kaansancakdar/Stewart_Platform/Lecture__Mathematics of the Stewart Platform.pdf

## The Mathematics of the Stewart Platform

The Stewart Platform consists of 2 rigid frames connected by 6 variable length legs.

The Base is considered to be the reference frame work, with orthogonal axes x, y, z.

The Platform has its own orthogonal coordinates x’, y’, z’.

The Platform has 6 degrees of freedom with respect to the Base

The origin of the Platform coordinates can be defined by 3 translational displacements with respect to the Base, one for each axis.

Three angular displacements then define the orientation of the platform with respect to the Base. A set of Euler angles are used in the following sequence:

1. Rotate an angle ψ (yaw) around the z-axis
2. Rotate an angle θ (pitch) around the y-axis
3. Rotate an angle (roll) around the x-axis

If we consider the first rotation ψ (yaw) around the z-axis:

P = i’x’ + j’y’ + k’z’ = ix + jy + kz

x = OA – BC

= x’cos ψ – y’sin ψ

y = AB + PC

= x’sin ψ + y’cos ψ

z = z’


We define the rotation matrix | where

=

and | =

Similarly If we consider the second rotation θ (pitch) around the y-axis we can show

=

,

And for the third rotation (roll) around the x-axis:

=

The full rotation matrix of the Platform relative to the Base is then given by:

=

=

=

=

- (1)

Now consider a Stewart Platform.

For the

leg:

Platform; Base

The coordinates | of the anchor point | with respect to the Base reference framework are
given by the equation

= T +

- (2)

Where T is the translation vector, giving the positional linear displacement of the origin of the Platform frame with respect to the Base reference framework, and

is the vector defining the coordinates of the anchor point with respect to the Platform framework.

Similarly the length of the

leg is given by

| = T +

- (3)
| where is the vector
defining the coordinates of the lower anchor point
| . These 6 equations give the lengths
of the 6 legs to achieve the desired position and attitude of the platform.

When considering the Forward Kinematics, this expression represents 18 simultaneous non-linear equations in the 6 unknowns representing the position and attitude of the platform. Much work has been done on finding the solutions to these equations; in the general case there are 40 possible solutions, although in practice many of these solutions would not be practical.

If the leg lengths are achieved via rotational servos, rather than linear servos, a further calculation is required to determine the angle of rotation of the servo. Each servo / leg combination can be represented as follows:

Axis of servo motor in x-y plane

y

z

Where: a = length of the servo operating arm

are the points of the arm/leg joint on the

servo with coordinates

=

in the base framework.

are the points of rotation of the servo arms with the coordinates

=

in the base framework.

are the points the joints between the operating rods and the platform,

with coordinates | =

in the platform framework

S = length of operating leg

= length of the
leg as calculated from

= T +

α = angle of servo operating arm from horizontal

β = angle of servo arm plane relative to the x-axis. Note that the shaft axis lies in the x-y plane where z = 0

z-axis; y-axis; x-axis; Sweep of arm; (i=even); (i=odd)

Point is constrained to be on the servo arm, but the arrangement of the servos means that the odd and even arms are a reflection of each other. So for the even legs we have:

= a | , and | - (4)
= a | , and | - (5)

= a | - (6)

And for the odd legs we have:

= a | , and
= a | , and

= a

But | = | , and | =
And | = | , and | =

Substituting these values into the equations for the odd legs, we get the same equations as (4), (5), and (6) for the even legs.

By Pythagoras we also have:

=

+

+

=

+

- 2
- (7)

=

+

+

=

+

- 2 | - (8)

=

+

+

=

+

- 2

And substituting from equations (7) & (8)

=

+ 2 | +

+
2
- 2

re-arranging gives

= 2

+ 2 | + 2 | + 2 | –
2
And substituting for | , | , | from equations (4), (5) & (6) then gives

= 2

+ 2

+
2

+ 2

2

= 2

+ 2 | + 2 | - 2

+
2a | + 2 | - 2
+ 2a | + 2 | -
2

Which reduces to

= 2a | 2 | + 2a
= 2a | 2a

Which is an equation of the form:-

L =

Using the Trig identity for the sum of sine waves

where

and

We therefore have another sine function of α with a phase shift δ

L = | where | δ =
Therefore | =
And | α =

- (9)

where L =

M = 2a

N = 2a

We now have sufficient information to calculate the lengths of the effective “legs”, and the associated angle of the servo arms, for the reverse kinematics for the platform. But to design and implement the hexapod platform we need to define a few constants in order to define the range of movement.

1) We need to define the “home” position of the platform. By definition this will be where the platform is at a height above the base framework, and there being no other translational or rotational movement.

i.e.

= T +

=

=

Similarly we will define the “home” position where the servo arms and rods are at right angles to each other.

i.e.

=

Giving

- (10)

and since the platform is constructed symmetrically around the z-axis, this equation will give the same result for any leg.

2) We can also calculate the angle of the servo arm at the Home position.

Using the equation

= T +

And remembering the symmetrical construction of the platform. The length of the legs in the “home” position is given by

- (11)

And the angle of the servo arm in the “home” position can be given by equation (9). Since we have symmetry, we can look at leg 2 only, where β = 0°.

=

- (12)

where =

= 2

| = 2a
| = 2a
| = 2a

The servos are mounted so that their mid point is close to the “home” position, and we will restrict their movement to ± 45°. The servos are controlled by a pulse whose duration defines the angle of the arm.

Pulse; Repetition every 20 msecs

The servos used have the specification:

Neutral position (“home”) is nominally 1500µsecs

Rotation clockwise for increasing pulse width

Pulse width change for 45° is 400 µsecs giving a servo rate,

r =

=

µsecs / radian

From the above, the pulse widths

for each of the servos can be obtained by the equations:

for even i and | -(13)
for odd i | - (14)

Where

is the actual pulse width required to hold the | servo in the “home”
position. This is nominally 1500µsecs, but can be adjusted to compensate for differences in actual assembly.

## Controlling the Stewart Platform using RC Servos

The platform is constructed with symmetry round the z-axes, but the odd and even servos are mounted in opposition.

The circuitry used to control the platform is based on a PICAXE microcontroller with attached maths co-processor (floating point) and attached servo motor controller.

PICAXE 40X2; µM-FPU; µM-PWM; I2c interface; Input position variables; Pulse output to servos

The sequence of events is as follows:

1) Input the positional information for the platform,

s, a,

. These are all
constants from the build of the platform.
2) Input the constants for the servo motors,

and r
3) Calculate the values of | from equation (10), and | from equation (12)
4) Input the variables for (x, y, z, ψ, θ, φ) for the required platform position
5) Calculate the rotational matrix

from equation (1)
6) Calculate the effective leg lengths
from equations (3)
7) Calculate the angles

required for each servo from equation (9)
8) Calculate the pulse widths

required for each servo from equations (13) & (14)
9) Output the values of

to the µM-PWM to drive the servos
10) Return to step 4) to repeat the process.
