kaansancakdar/Stewart_Platform/memememe-master/memememe-master/Processing/StewartSimulator/README.md

###Stewart Platform Simulator

Math based on [this document](http://www.wokinghamu3a.org.uk/Maths%20of%20the%20Stewart%20Platform%20v5.pdf) by an unknown author from the [U3A Maths Group](http://www.wokinghamu3a.org.uk/Maths.html)  

###Dependencie:  
- [peasycam](http://mrfeinberg.com/peasycam/)  
- [controlP5](http://www.sojamo.de/libraries/controlP5/)  
- [oscP5](http://www.sojamo.de/libraries/oscP5/)
