kaansancakdar/Stewart_Platform/CAD/New Microsoft PowerPoint Presentation.pptx

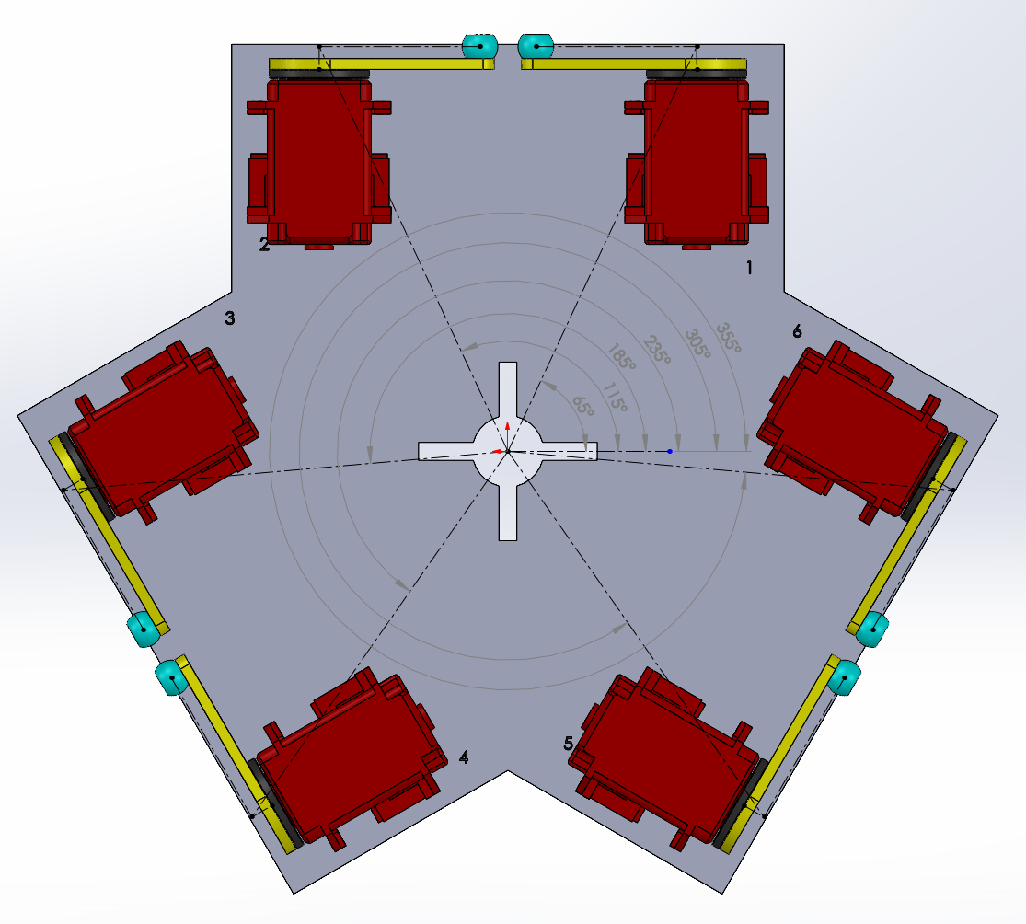
[picture p15: figure]

## Slide 2

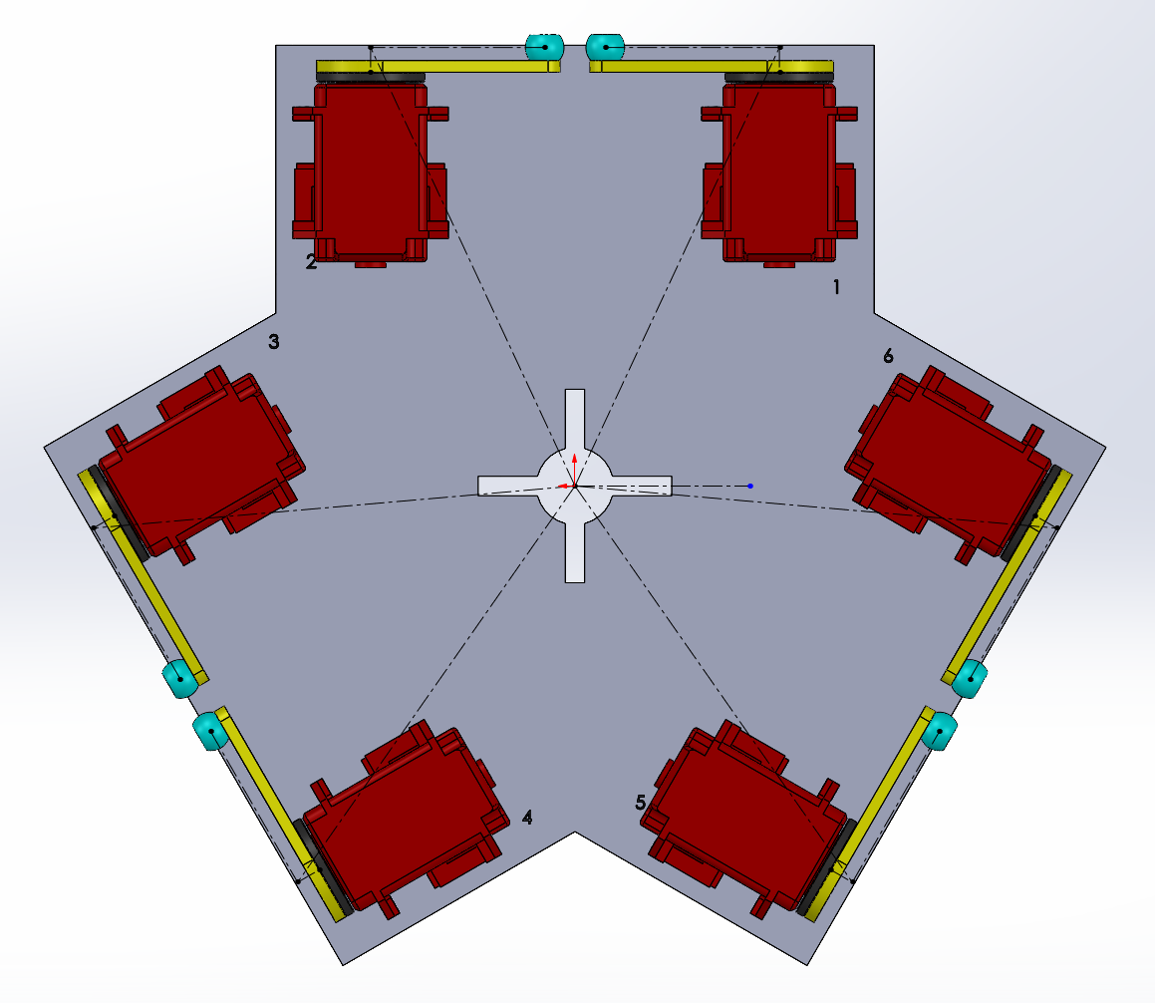
[picture p16: figure]

## Slide 3

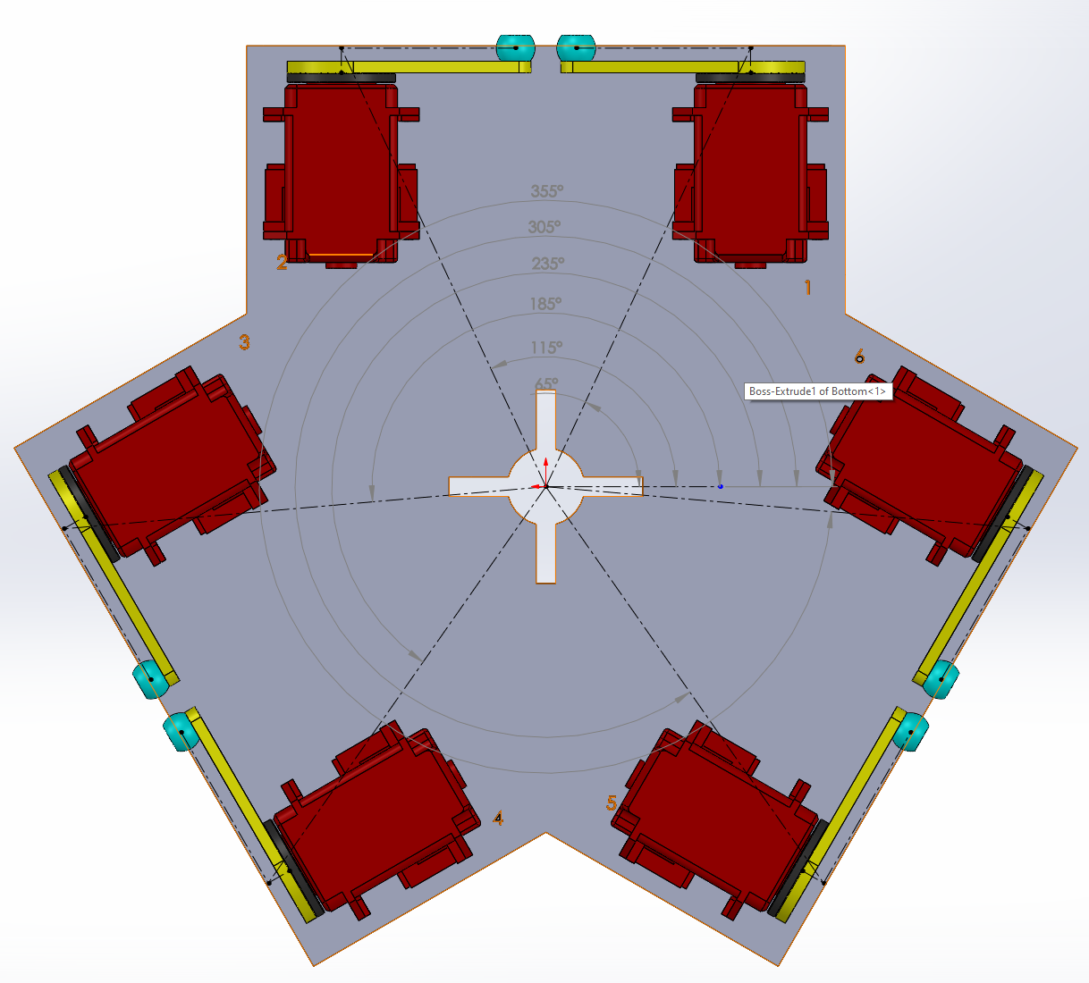
[picture p17: figure]
