kaansancakdar/Stewart_Platform/Literature/F2ES5AQHW0FU98M.png

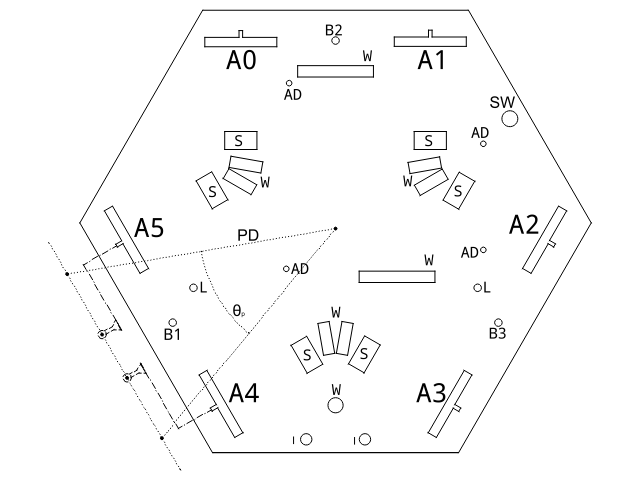
Literature/F2ES5AQHW0FU98M.png
