kaansancakdar/Stewart_Platform/Literature/F15E12CHW1M979X.png

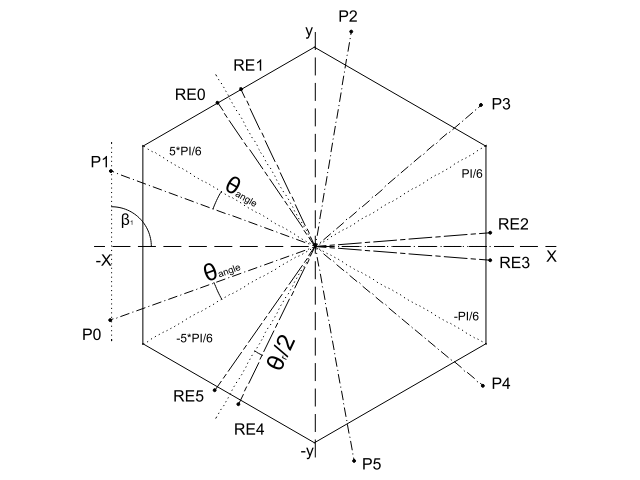
Literature/F15E12CHW1M979X.png
