kaansancakdar/Stewart_Platform/CAD/Assem1.SLDASM

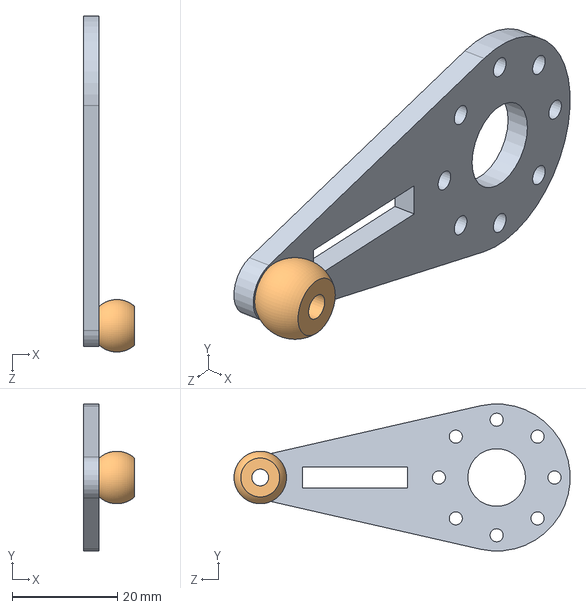
[picture p27: CAD file, 2025-04-02]
CAD/Assem1.SLDASM
9.73 x 27.9 x 64.0 mm
ServoArm
BallJoint2
