kaansancakdar/Stewart_Platform/CAD/LinearActuated.SLDASM

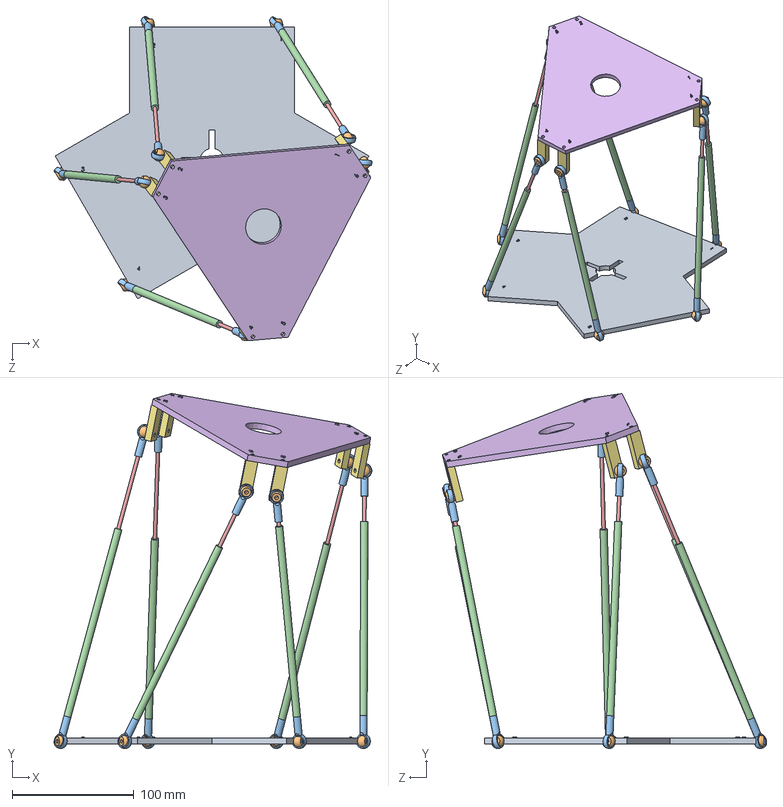
[picture p28: CAD file, 2025-04-02]
CAD/LinearActuated.SLDASM
261.5 x 292.1 x 267.0 mm
Bottom_1
BallJoint2 x 12
BallJoint_1 x 12
Link_2 x 6
Link_1 x 6
Platform_1
JointHolder x 6
