kaansancakdar/Stewart_Platform/CAD/Stewart_Platform_CAD/STW_001000.SLDASM

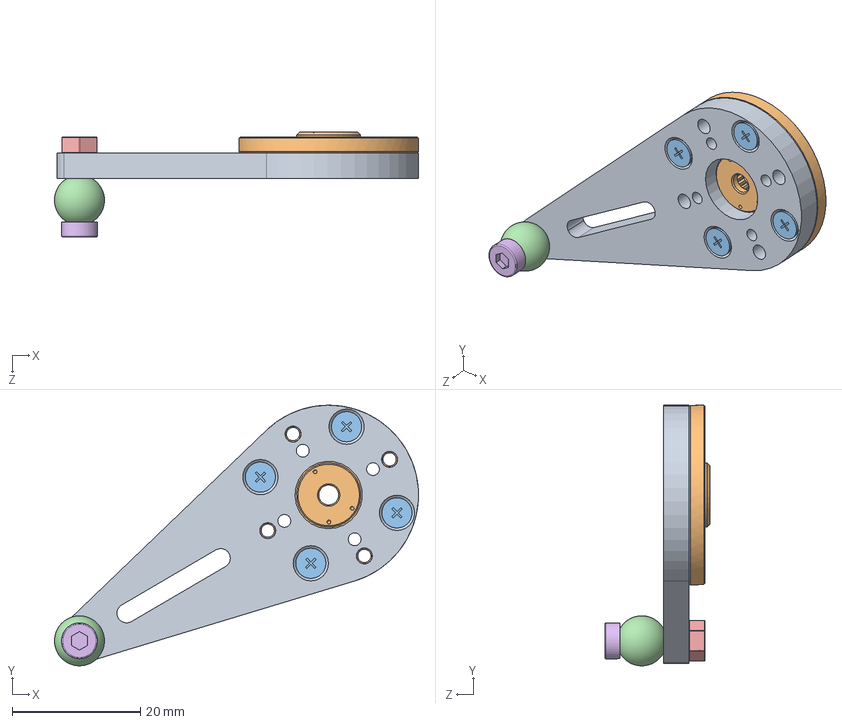
[picture p29: CAD file, 2025-04-02]
CAD/Stewart_Platform_CAD/STW_001000.SLDASM
56.7 x 40.6 x 16.4 mm
STW_0010001
Dynamixel_HN05-N102
DIN965-M2.5x6 x 4
BallJoint_Ball
C.020.00000753-(#DIN934-M3_Nut)
C.020.00000880-(#DIN912-M3x12_Socket Head Screw)
