kaansancakdar/Stewart_Platform/CAD/Assem0.SLDASM

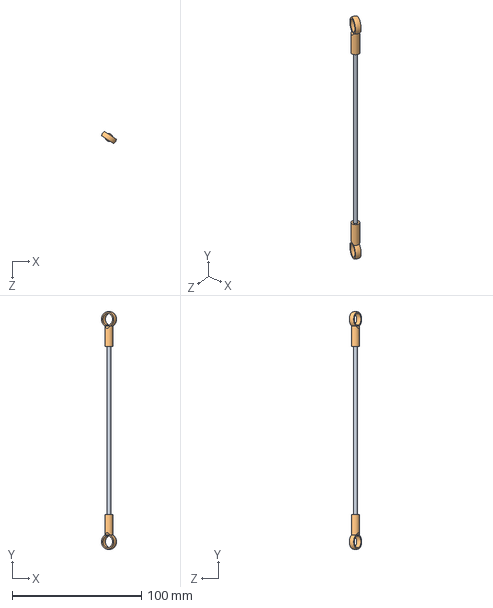
[picture p30: CAD file, 2025-04-02]
CAD/Assem0.SLDASM
11.7 x 184.0 x 9.55 mm
Link_1
BallJoint_1 x 2
