kaansancakdar/Stewart_Platform/CAD/Stewart_Platform_CAD/STW_005000.SLDASM

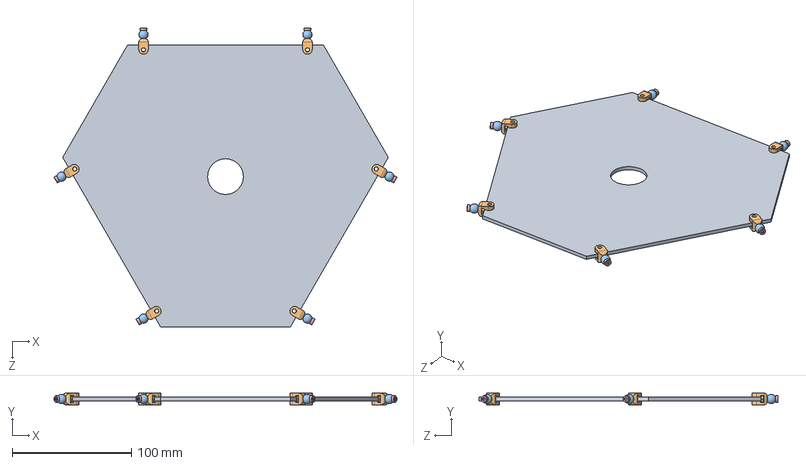
[picture p31: CAD file, 2025-04-02]
CAD/Stewart_Platform_CAD/STW_005000.SLDASM
287.1 x 10.0 x 250.7 mm
STW_003001
STW_004001 x 6
BallJoint_Ball x 6
C.020.00000753-(#DIN934-M3_Nut) x 6
C.020.00000880-(#DIN912-M3x12_Socket Head Screw) x 6
