kaansancakdar/Stewart_Platform/CAD/Stewart_Platform_CAD/STW_002000.SLDASM

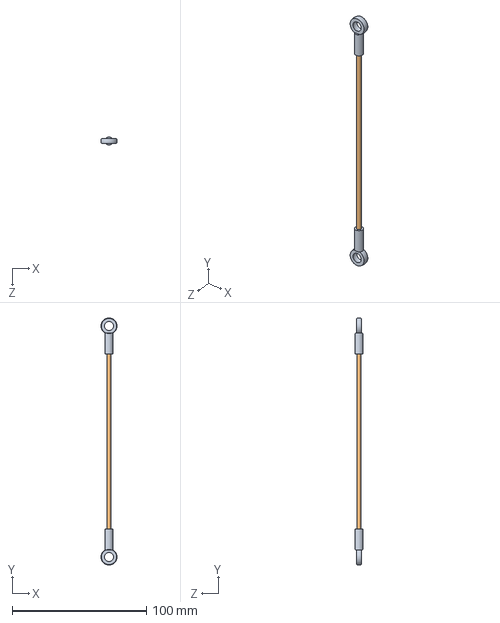
[picture p32: CAD file, 2025-04-02]
CAD/Stewart_Platform_CAD/STW_002000.SLDASM
12.0 x 184.0 x 5.98 mm
BallJoint_Pin x 2
STW_0020001
