kaansancakdar/Stewart_Platform/CAD/Assem2.SLDASM

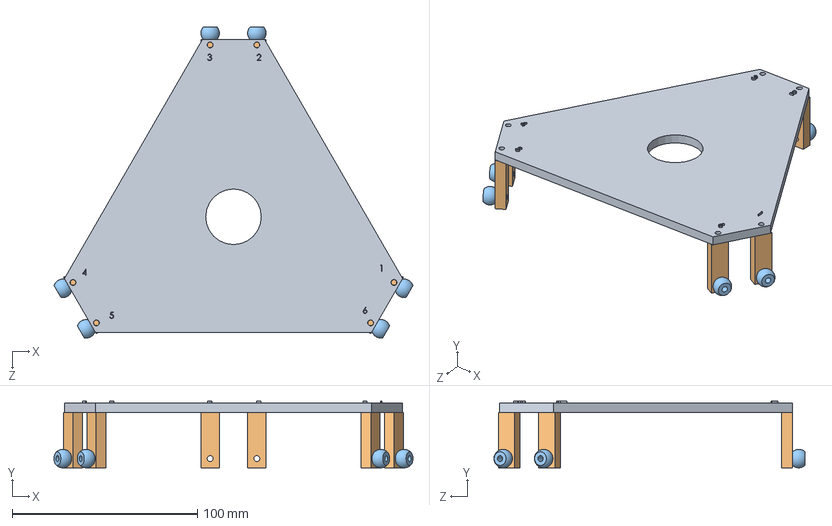
[picture p33: CAD file, 2025-04-02]
CAD/Assem2.SLDASM
193.9 x 36.0 x 168.0 mm
Platform_1
JointHolder x 6
BallJoint2 x 6
