kaansancakdar/Stewart_Platform/CAD/Assem02.SLDASM

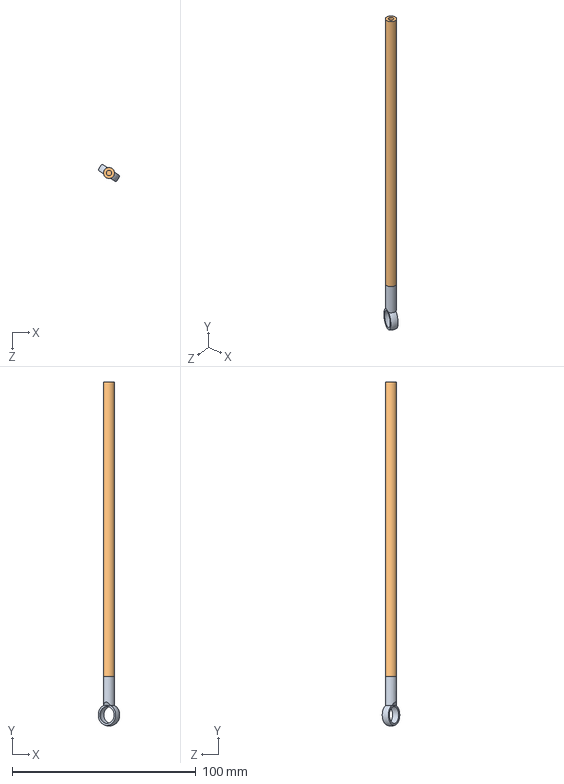
[picture p34: CAD file, 2025-04-02]
CAD/Assem02.SLDASM
11.7 x 187.0 x 9.55 mm
BallJoint_1
Link_2
