kaansancakdar/Stewart_Platform/CAD/Stewart_Platform_CAD/STW_000000.SLDASM

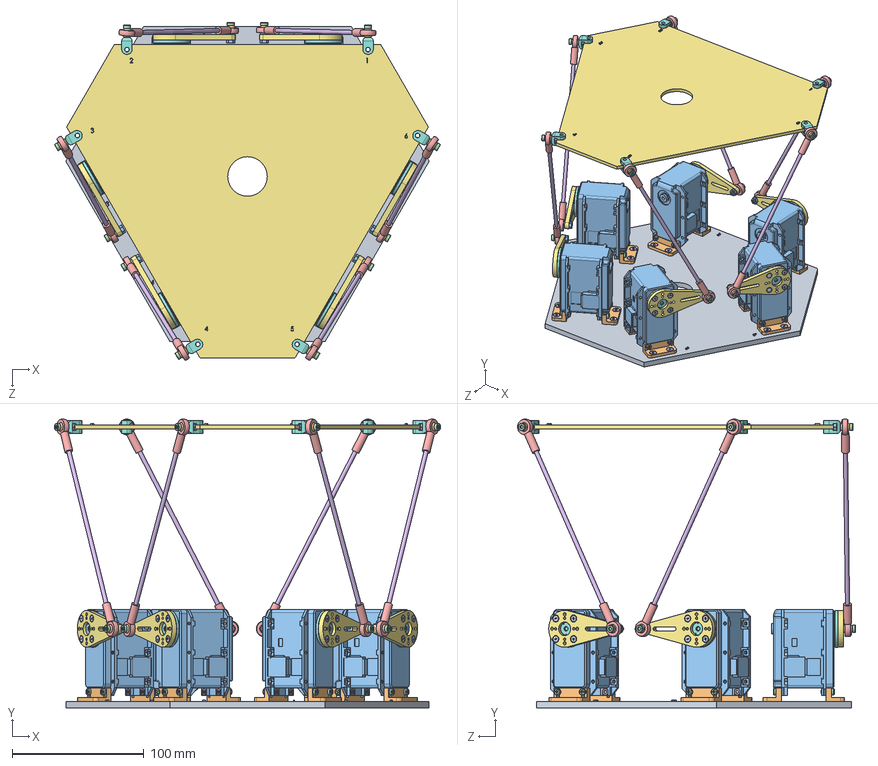
[picture p35: CAD file, 2025-04-02]
CAD/Stewart_Platform_CAD/STW_000000.SLDASM
292.6 x 219.0 x 256.1 mm
STW_000001
STW_000002 x 12
Dynamixel_MX106R x 6
C.020.00000XXX-(#DIN7985-M2.5X08MM-Machine Screw) x 24
C.020.00000XXX-(#DIN934-M2.5 NUT) x 12
C.020.00000XXX-(#DIN7991-M3X08MM HAVSA IMBUS) x 24
STW_0010001 x 6
Dynamixel_HN05-N102 x 6
DIN965-M2.5x6 x 24
BallJoint_Ball x 12
C.020.00000753-(#DIN934-M3_Nut) x 12
C.020.00000880-(#DIN912-M3x12_Socket Head Screw) x 12
BallJoint_Pin x 12
STW_0020001 x 6
STW_003001
STW_004001 x 6
