kaansancakdar/Stewart_Platform/CAD/Stewart_Platform_CAD/STW_004000.SLDASM

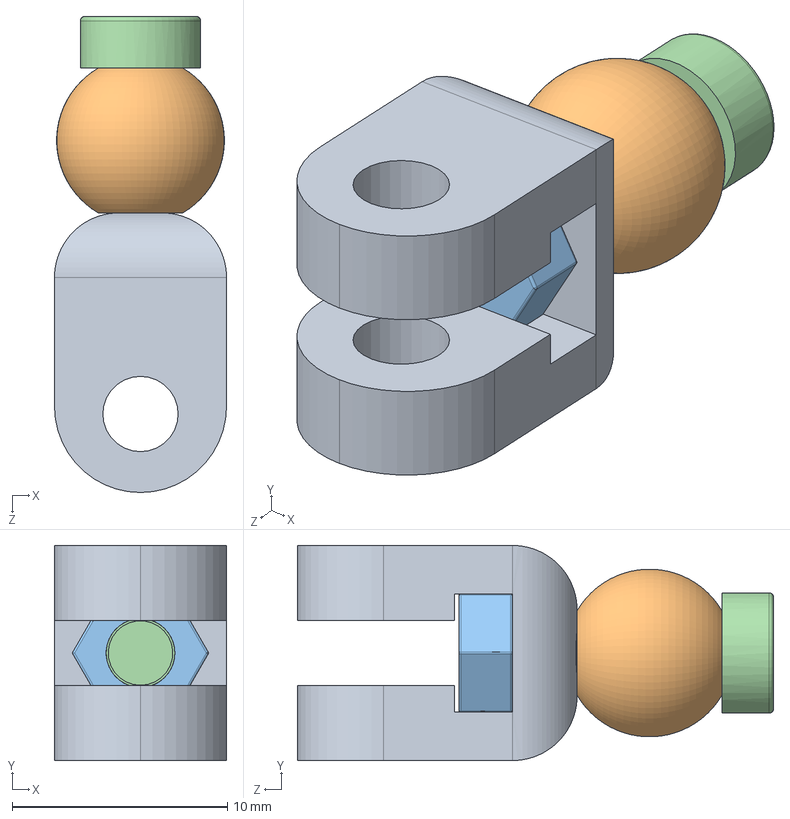
[picture p36: CAD file, 2025-04-02]
CAD/Stewart_Platform_CAD/STW_004000.SLDASM
8.00 x 10.0 x 22.1 mm
STW_004001
BallJoint_Ball
C.020.00000753-(#DIN934-M3_Nut)
C.020.00000880-(#DIN912-M3x12_Socket Head Screw)
