kaansancakdar/Stewart_Platform/CAD/Link_2.SLDPRT

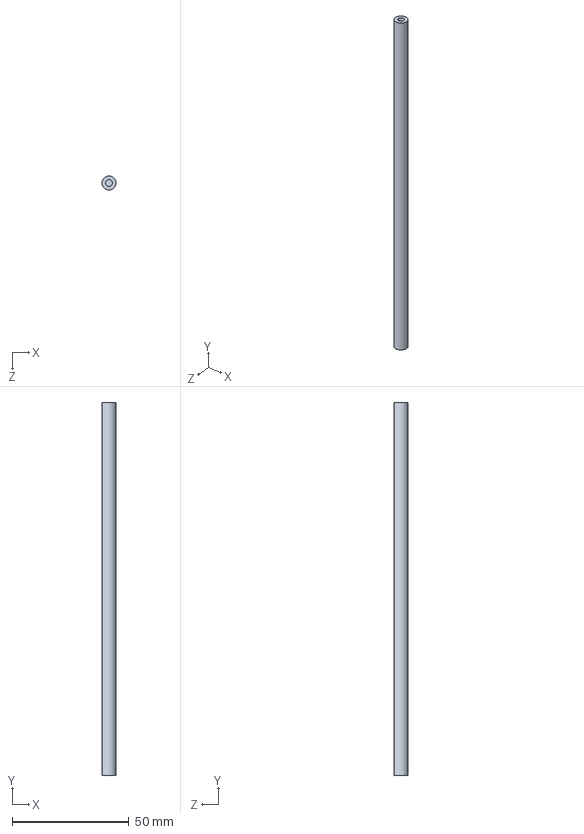
[picture p37: CAD file, 2025-04-02]
CAD/Link_2.SLDPRT
6.00 x 160.0 x 6.00 mm
