kaansancakdar/Stewart_Platform/CAD/Stewart_Platform_CAD/STW_0020001.SLDPRT

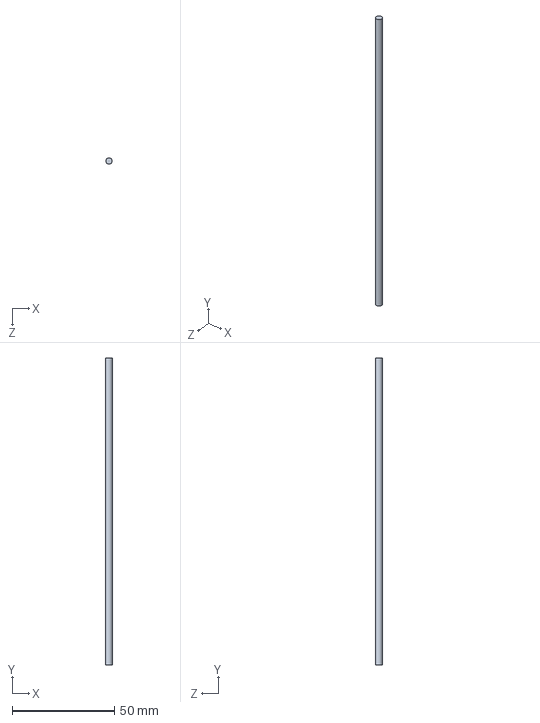
[picture p38: CAD file, 2025-04-02]
CAD/Stewart_Platform_CAD/STW_0020001.SLDPRT
3.20 x 150.0 x 3.20 mm
