kaansancakdar/Stewart_Platform/RotaryStewartPlatform-master/RotaryStewartPlatform-master/templates_for_cutting/base_bot.dxf

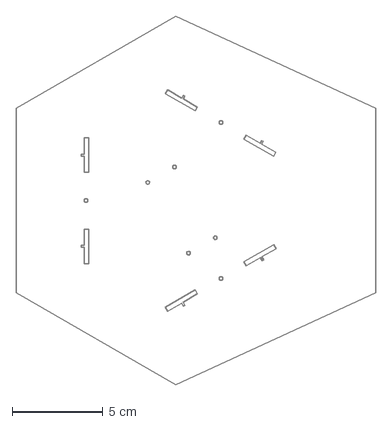
[picture p39: CAD file, 2025-04-02]
RotaryStewartPlatform-master/RotaryStewartPlatform-master/templates_for_cutting/base_bot.dxf
19.8 x 20.3 cm
