kaansancakdar/Stewart_Platform/RotaryStewartPlatform-master/templates_for_cutting/platform_bot.dxf

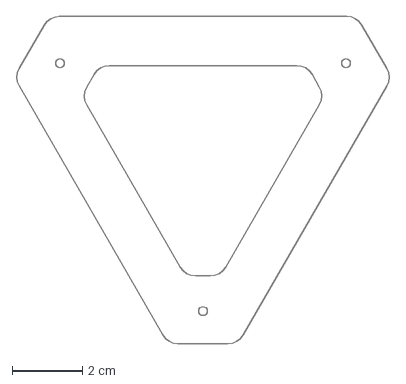
[picture p40: CAD file, 2025-04-02]
RotaryStewartPlatform-master/templates_for_cutting/platform_bot.dxf
10.6 x 9.31 cm
