kaansancakdar/Stewart_Platform/CAD/Link_1.SLDPRT

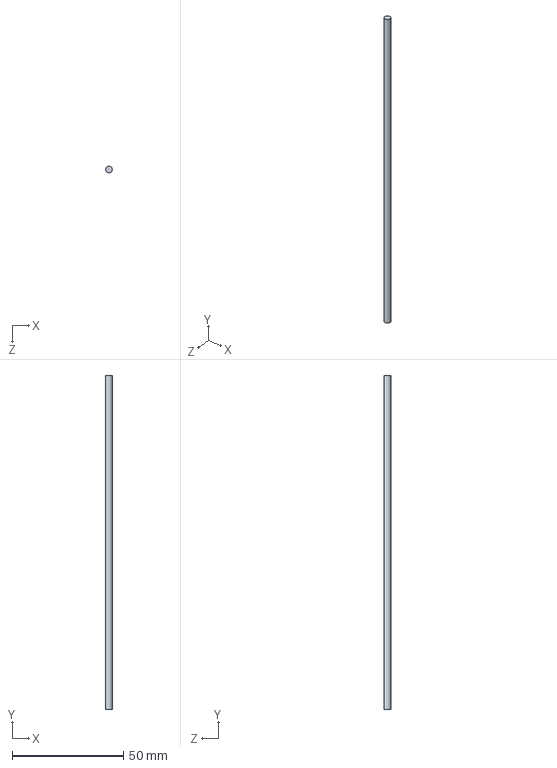
[picture p41: CAD file, 2025-04-02]
CAD/Link_1.SLDPRT
3.00 x 150.0 x 3.00 mm
