kaansancakdar/Stewart_Platform/RotaryStewartPlatform-master/RotaryStewartPlatform-master/templates_for_cutting/platform_top.dxf

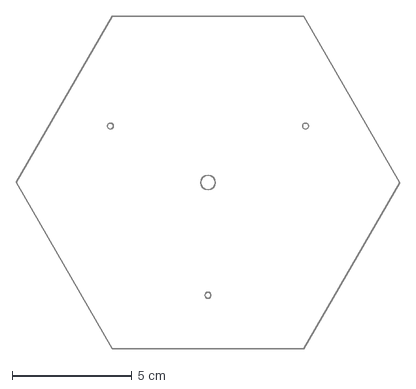
[picture p42: CAD file, 2025-04-02]
RotaryStewartPlatform-master/RotaryStewartPlatform-master/templates_for_cutting/platform_top.dxf
16.0 x 13.9 cm
