kaansancakdar/Stewart_Platform/RotaryStewartPlatform-master/templates_for_cutting/base_top.dxf

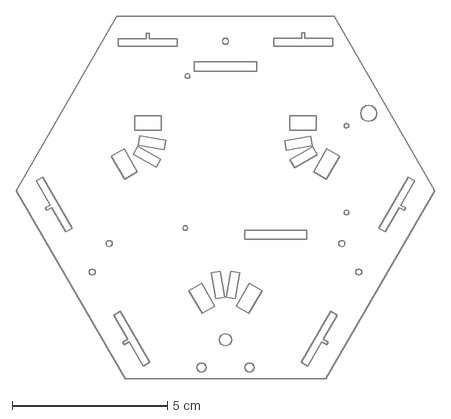
[picture p43: CAD file, 2025-04-02]
RotaryStewartPlatform-master/templates_for_cutting/base_top.dxf
13.5 x 11.7 cm
