kaansancakdar/Stewart_Platform/CAD/Stewart_Platform_CAD/STW_000003.SLDPRT

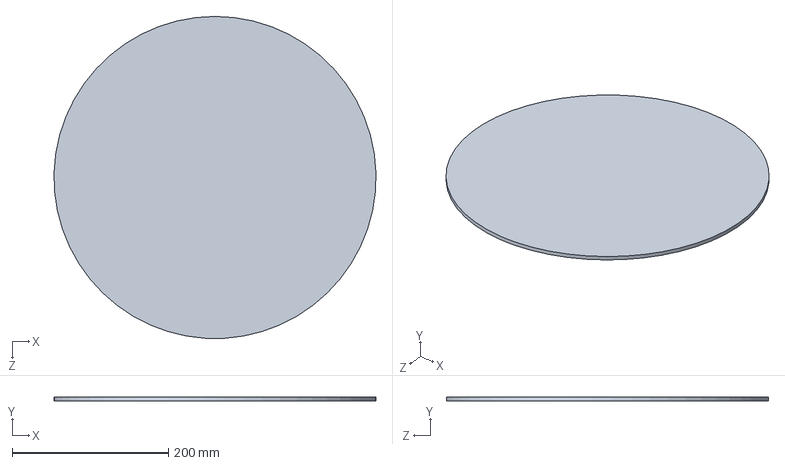
[picture p44: CAD file, 2025-04-02]
CAD/Stewart_Platform_CAD/STW_000003.SLDPRT
412.5 x 5.00 x 412.6 mm
