kaansancakdar/Stewart_Platform/RotaryStewartPlatform-master/RotaryStewartPlatform-master/templates_for_cutting/servo_arm.dxf

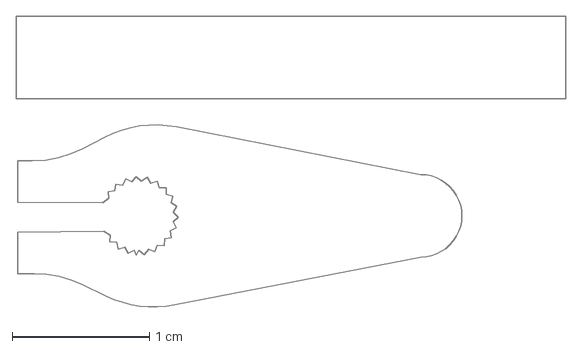
[picture p45: CAD file, 2025-04-02]
RotaryStewartPlatform-master/RotaryStewartPlatform-master/templates_for_cutting/servo_arm.dxf
4.00 x 2.13 cm
