kaansancakdar/Stewart_Platform/CAD/Bottom.SLDPRT

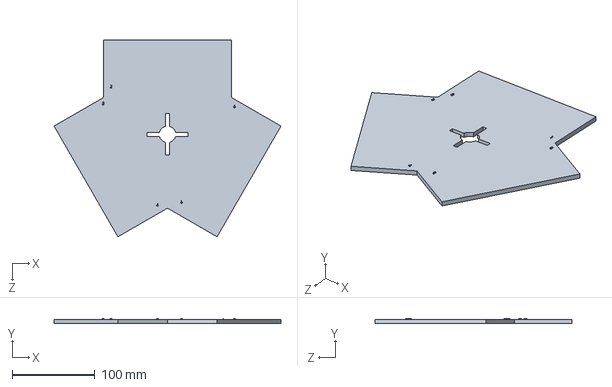
[picture p46: CAD file, 2025-04-02]
CAD/Bottom.SLDPRT
274.6 x 6.00 x 237.8 mm
