kaansancakdar/Stewart_Platform/CAD/Stewart_Platform_CAD/C.020.00000XXX-(#DIN7991-M3X08MM HAVSA IMBUS).SLDPRT

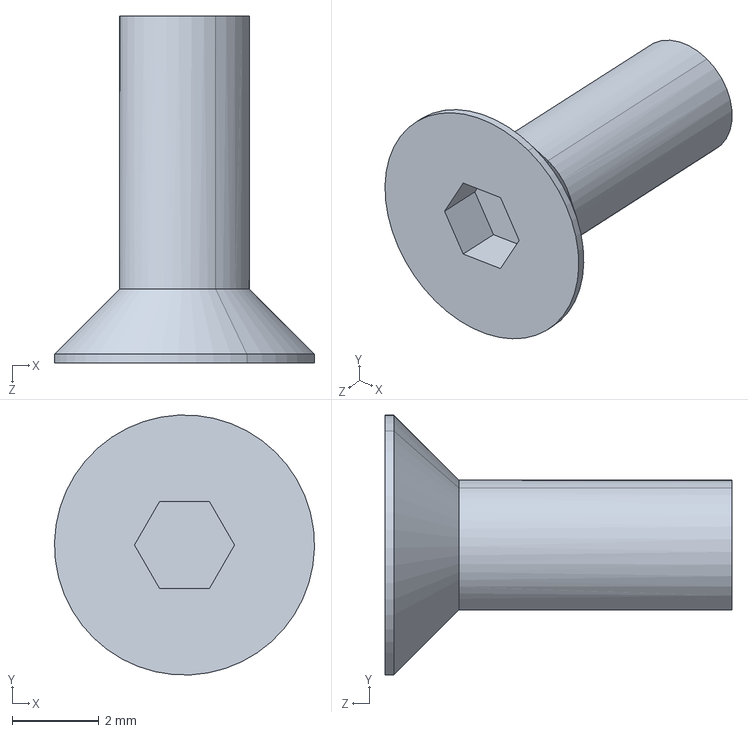
[picture p47: CAD file, 2025-04-02]
CAD/Stewart_Platform_CAD/C.020.00000XXX-(#DIN7991-M3X08MM HAVSA IMBUS).SLDPRT
6.00 x 5.99 x 8.00 mm
