kaansancakdar/Stewart_Platform/CAD/Bottom_1.SLDPRT

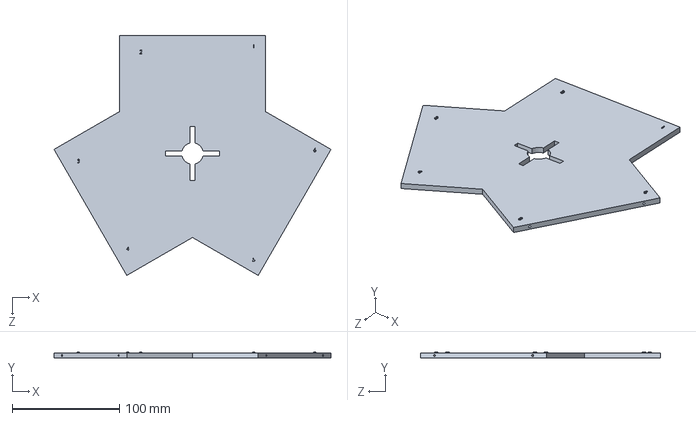
[picture p48: CAD file, 2025-04-02]
CAD/Bottom_1.SLDPRT
258.2 x 6.00 x 223.6 mm
