kaansancakdar/Stewart_Platform/CAD/Stewart_Platform_CAD/STW_000001.SLDPRT

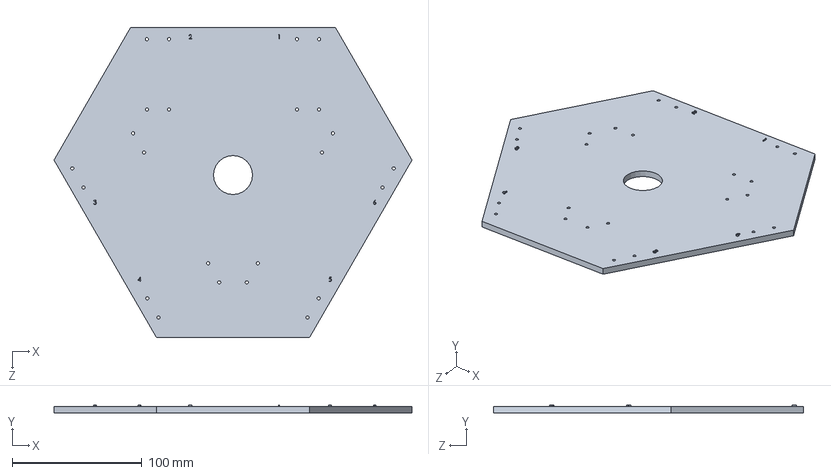
[picture p49: CAD file, 2025-04-02]
CAD/Stewart_Platform_CAD/STW_000001.SLDPRT
275.4 x 6.00 x 238.5 mm
