kaansancakdar/Stewart_Platform/CAD/BallJoint1.SLDPRT

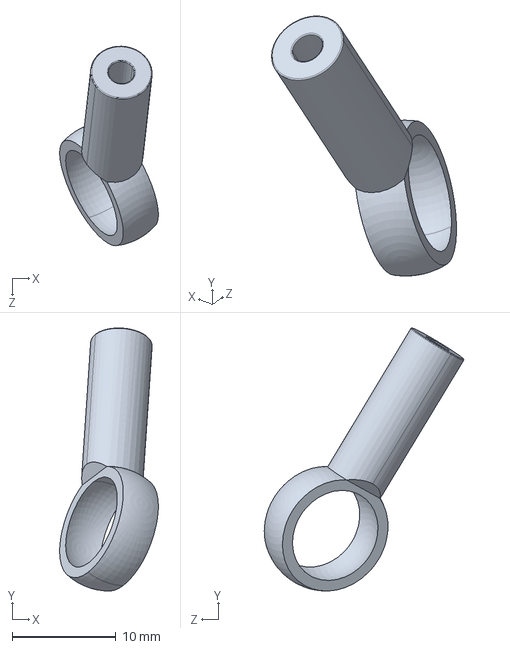
[picture p50: CAD file, 2025-04-02]
CAD/BallJoint1.SLDPRT
9.50 x 25.3 x 19.2 mm
