kaansancakdar/Stewart_Platform/CAD/Stewart_Platform_CAD/C.020.00000XXX-(#DIN934-M2.5 NUT).SLDPRT

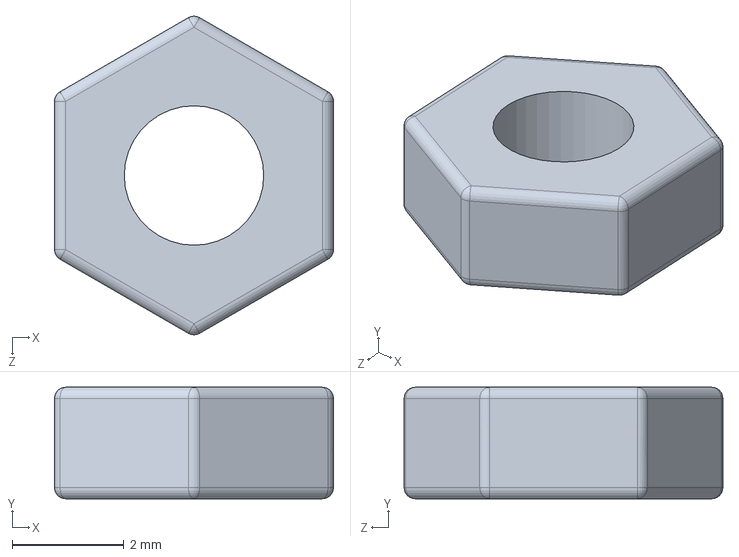
[picture p51: CAD file, 2025-04-02]
CAD/Stewart_Platform_CAD/C.020.00000XXX-(#DIN934-M2.5 NUT).SLDPRT
5.00 x 2.00 x 5.71 mm
