kaansancakdar/Stewart_Platform/CAD/Dynamixel_MX106R.SLDPRT

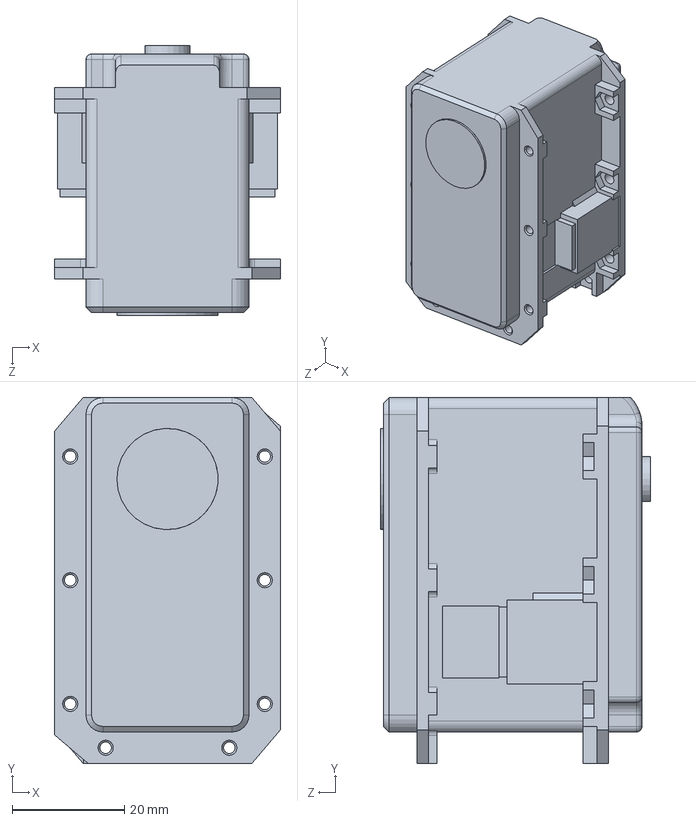
[picture p52: CAD file, 2025-04-02]
CAD/Dynamixel_MX106R.SLDPRT
40.2 x 65.1 x 48.0 mm
