kaansancakdar/Stewart_Platform/CAD/Assem3.STEP

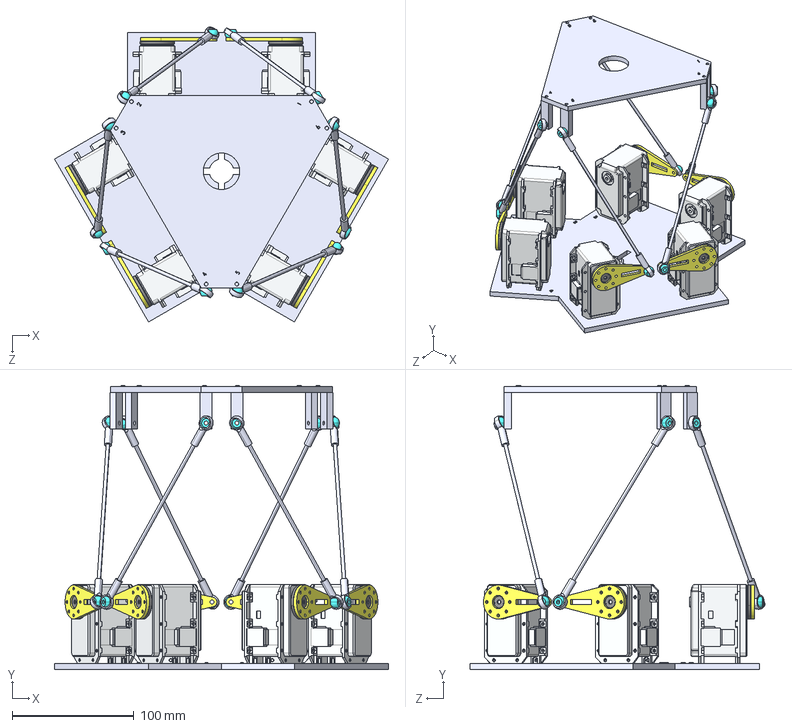
[picture p53: CAD file, 2025-04-02]
CAD/Assem3.STEP
274.6 x 233.7 x 242.5 mm
Bottom
Dynamixel_MX106R x 6
Dynamixel_HN05-N102 x 6
ServoArm x 6
BallJoint2 x 12
Link_1 x 6
BallJoint_1 x 12
Platform_1
JointHolder x 6
