kaansancakdar/Stewart_Platform/CAD/Platform.SLDPRT

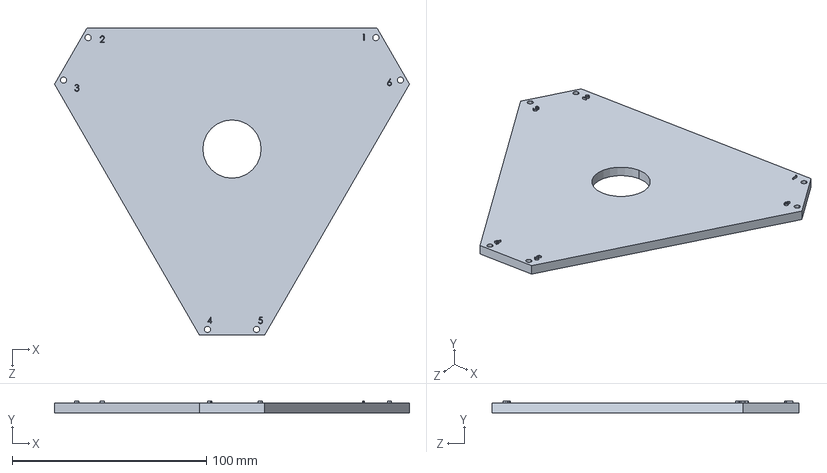
[picture p54: CAD file, 2025-04-02]
CAD/Platform.SLDPRT
182.6 x 6.00 x 158.2 mm
