kaansancakdar/Stewart_Platform/CAD/Stewart_Platform_CAD/STW_003001.SLDPRT

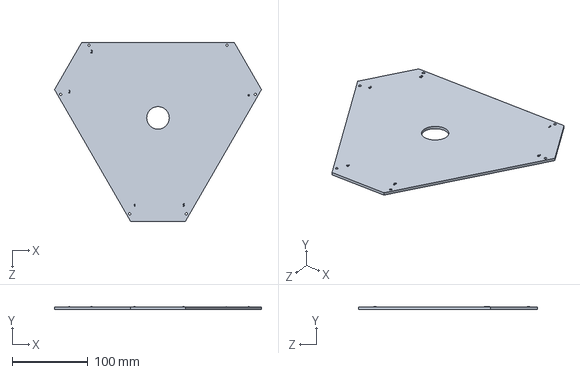
[picture p55: CAD file, 2025-04-02]
CAD/Stewart_Platform_CAD/STW_003001.SLDPRT
274.2 x 4.00 x 237.5 mm
