kaansancakdar/Stewart_Platform/CAD/Stewart_Platform_CAD/BallJoint_Pin.SLDPRT

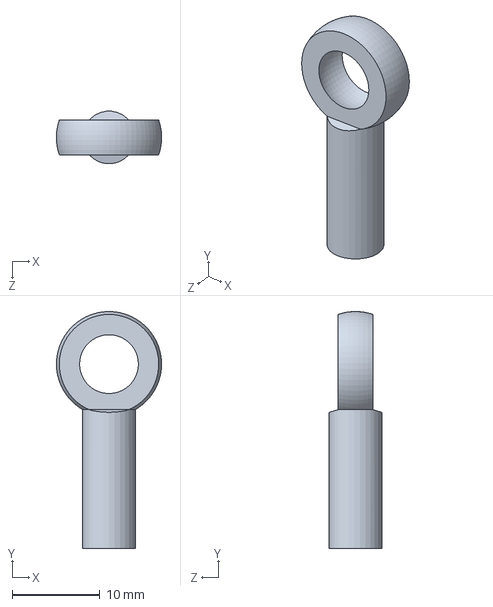
[picture p56: CAD file, 2025-04-02]
CAD/Stewart_Platform_CAD/BallJoint_Pin.SLDPRT
12.0 x 27.0 x 5.98 mm
