kaansancakdar/Stewart_Platform/CAD/Dynamixel_HN05-N102.SLDPRT

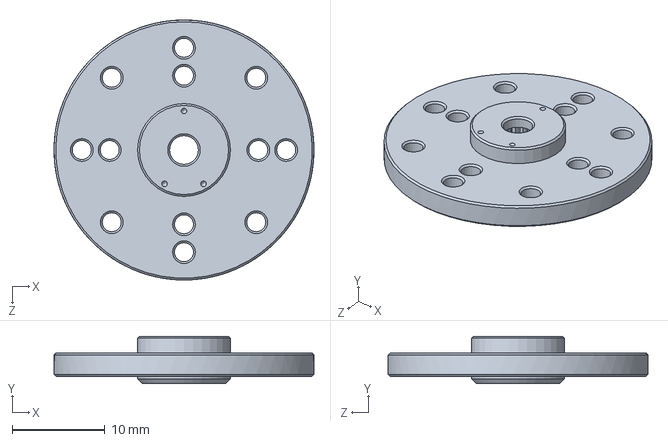
[picture p57: CAD file, 2025-04-02]
CAD/Dynamixel_HN05-N102.SLDPRT
28.0 x 5.10 x 28.0 mm
