kaansancakdar/Stewart_Platform/CAD/JointHolder.SLDPRT

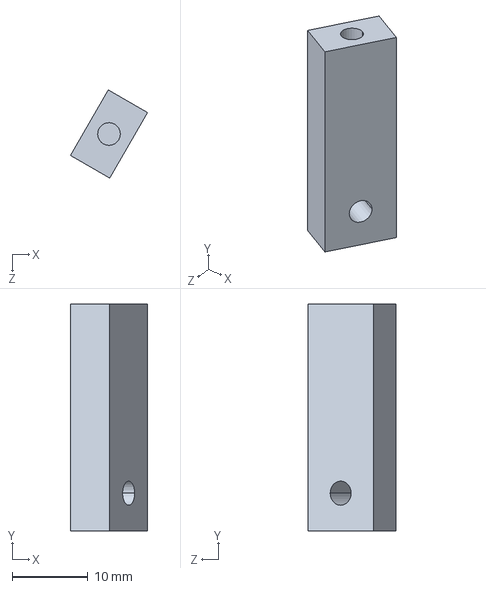
[picture p58: CAD file, 2025-04-02]
CAD/JointHolder.SLDPRT
10.2 x 30.0 x 11.7 mm
