kaansancakdar/Stewart_Platform/CAD/Stewart_Platform_CAD/BallJoint_Ball.SLDPRT

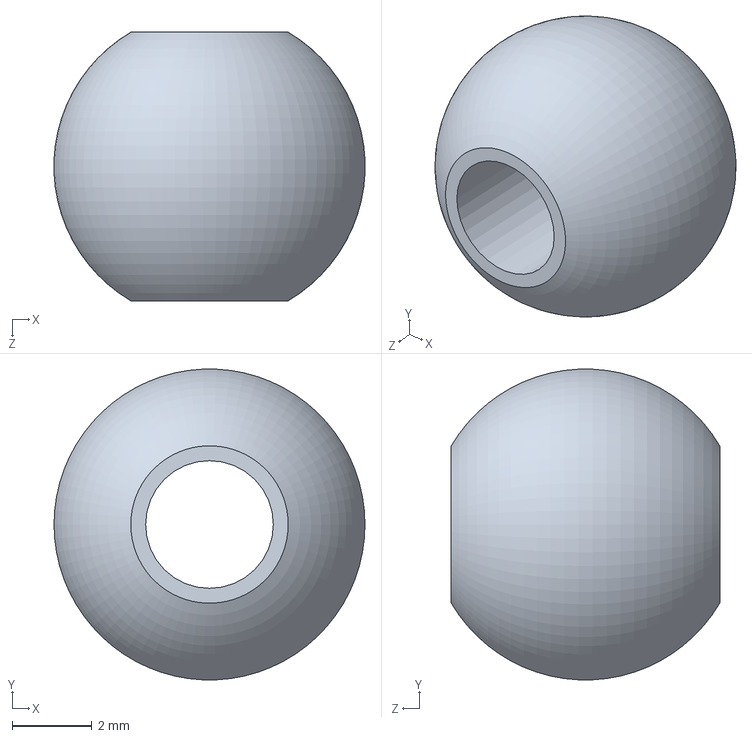
[picture p59: CAD file, 2025-04-02]
CAD/Stewart_Platform_CAD/BallJoint_Ball.SLDPRT
7.79 x 7.78 x 6.73 mm
