kaansancakdar/Stewart_Platform/CAD/Stewart_Platform_CAD/STW_0010001.SLDPRT

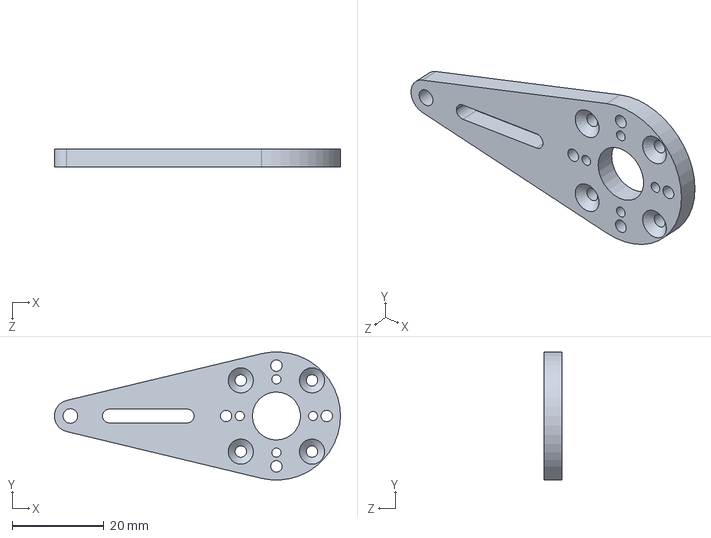
[picture p60: CAD file, 2025-04-02]
CAD/Stewart_Platform_CAD/STW_0010001.SLDPRT
62.5 x 27.9 x 4.00 mm
