kaansancakdar/Stewart_Platform/CAD/Link.SLDPRT

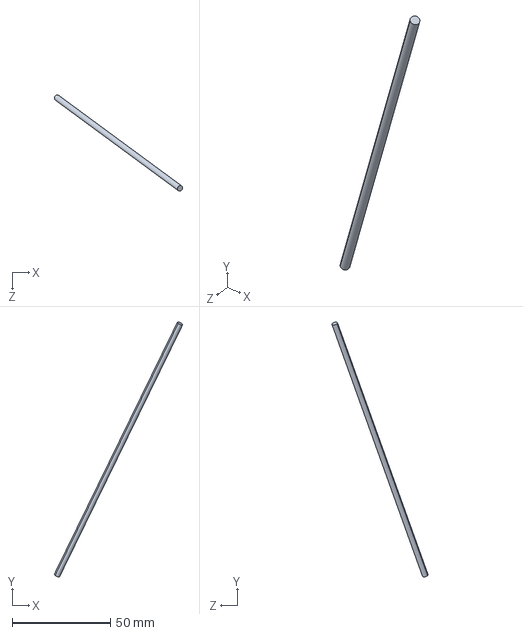
[picture p61: CAD file, 2025-04-02]
CAD/Link.SLDPRT
65.4 x 129.8 x 49.0 mm
