kaansancakdar/Stewart_Platform/CAD/ServoArm.SLDPRT

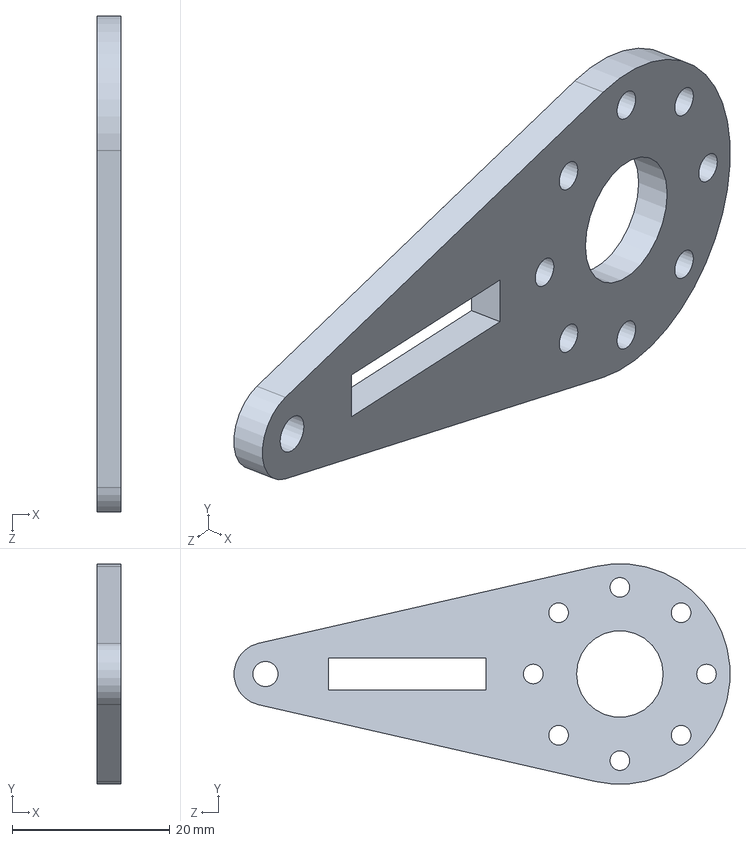
[picture p62: CAD file, 2025-04-02]
CAD/ServoArm.SLDPRT
3.00 x 27.9 x 62.9 mm
