kaansancakdar/Stewart_Platform/CAD/Stewart_Platform_CAD/STW_000002.SLDPRT

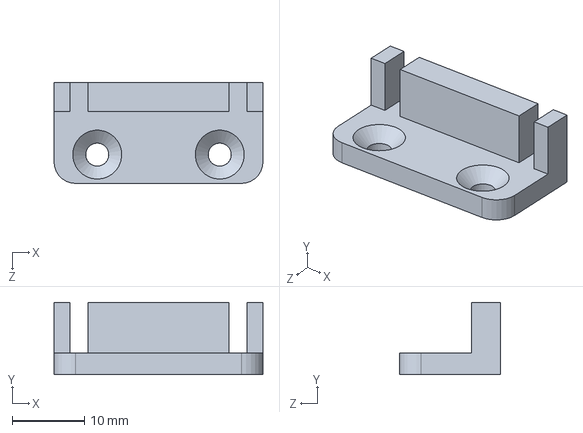
[picture p63: CAD file, 2025-04-02]
CAD/Stewart_Platform_CAD/STW_000002.SLDPRT
29.0 x 10.0 x 14.0 mm
