kaansancakdar/Stewart_Platform/CAD/Stewart_Platform_CAD/STW_004001.SLDPRT

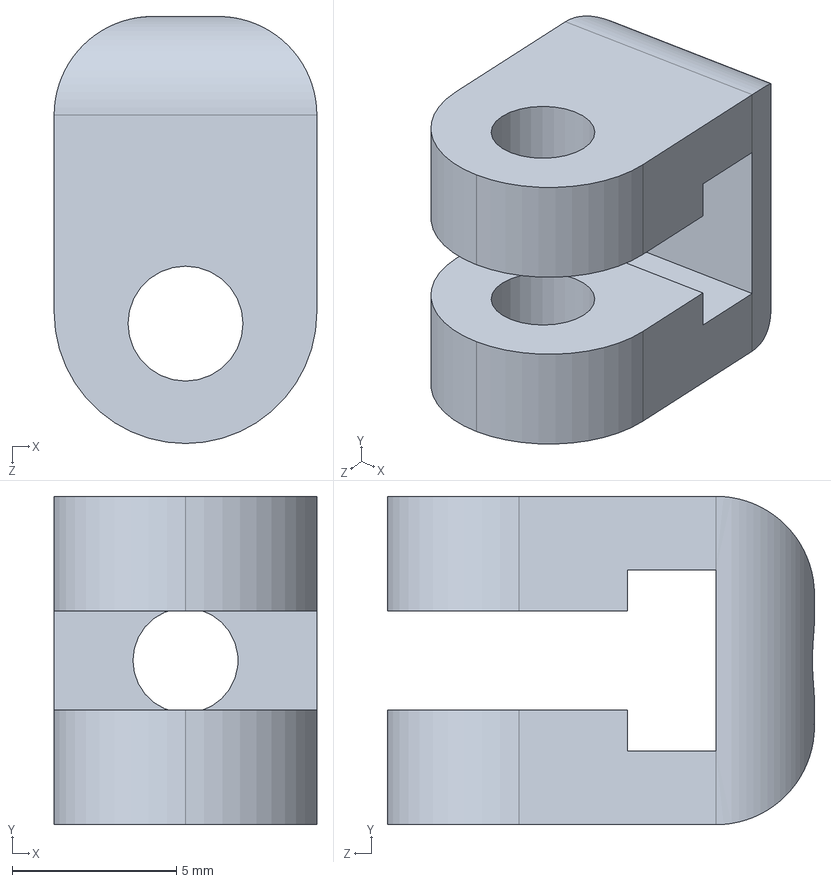
[picture p64: CAD file, 2025-04-02]
CAD/Stewart_Platform_CAD/STW_004001.SLDPRT
8.00 x 10.0 x 13.0 mm
