kaansancakdar/Stewart_Platform/CAD/Stewart_Platform_CAD/C.020.00000753-(#DIN934-M3_Nut).SLDPRT

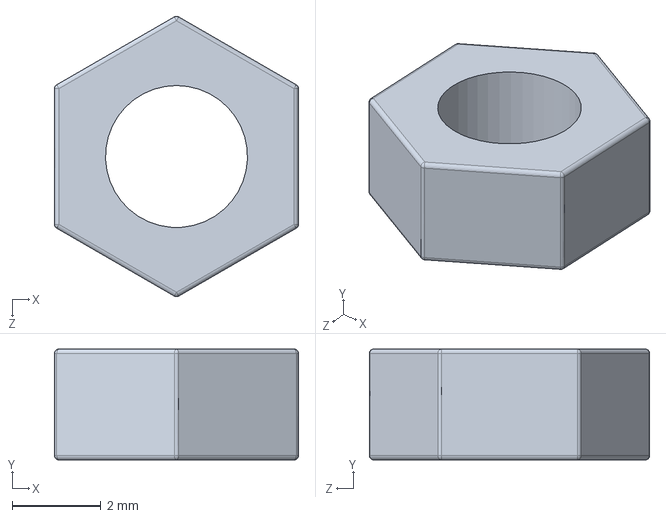
[picture p65: CAD file, 2025-04-02]
CAD/Stewart_Platform_CAD/C.020.00000753-(#DIN934-M3_Nut).SLDPRT
5.50 x 2.50 x 6.32 mm
