kaansancakdar/Stewart_Platform/CAD/Stewart_Platform_CAD/STW_0010002.SLDPRT

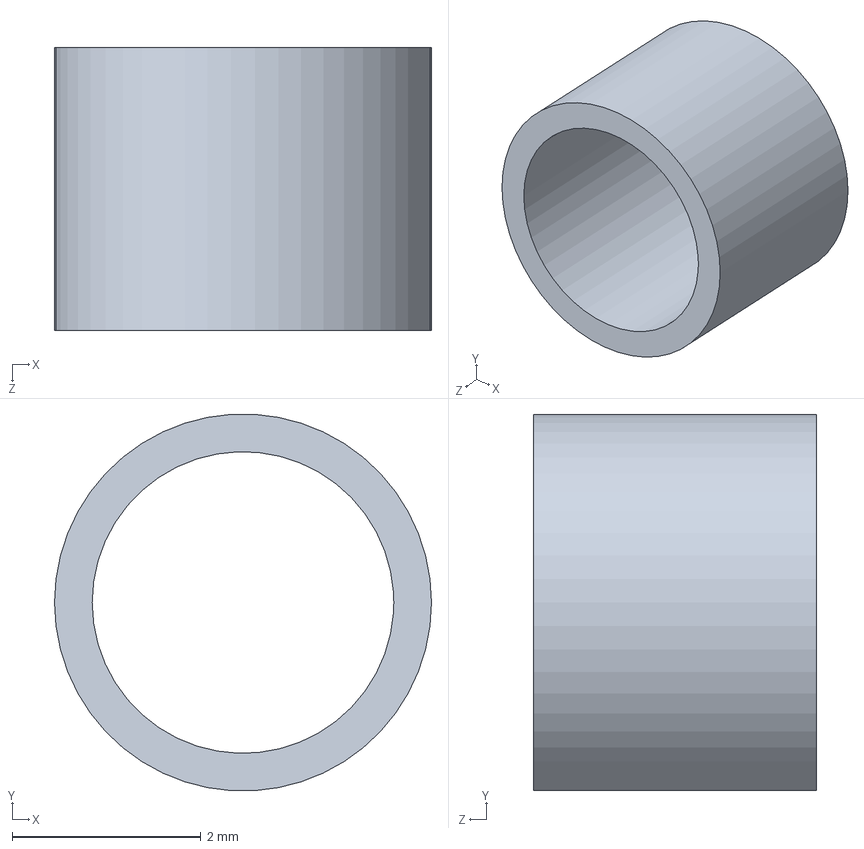
[picture p66: CAD file, 2025-04-02]
CAD/Stewart_Platform_CAD/STW_0010002.SLDPRT
4.00 x 3.99 x 3.00 mm
