kaansancakdar/Stewart_Platform/(list of files, cad)

Other CAD files:
CAD/Stewart_Platform_CAD/MirrorSTW_000002.SLDPRT
CAD/Stewart_Platform_CAD/Dynamixel_MX106R.SLDPRT
CAD/BallJoint2.SLDPRT
CAD/Platform_1.SLDPRT
CAD/ASSEM3.CATProduct
CAD/Assem0 - Copy.SLDASM
CAD/Assem3 - Copy.SLDASM
CAD/Assem3.SLDASM
CAD/BALLJOINT2.CATPart
CAD/BALLJOINT_1.CATPart
CAD/BOTTOM.CATPart
CAD/BallJoint_1.SLDPRT
CAD/DYNAMIXEL_HN05-N102.CATPart
CAD/DYNAMIXEL_MX106R.CATPart
CAD/JOINTHOLDER.CATPart
CAD/LINK_1.CATPart
CAD/PLATFORM_1.CATPart
CAD/Part1.CATPart
CAD/SERVOARM.CATPart
CAD/Stewart_Platform_CAD/C.020.00000880-(#DIN912-M3x12_Socket Head Screw).SLDPRT
CAD/Stewart_Platform_CAD/C.020.00000XXX-(#DIN7985-M2.5X08MM-Machine Screw).SLDPRT
CAD/Stewart_Platform_CAD/DIN965-M2.5x6.SLDPRT
CAD/Stewart_Platform_CAD/DIN965-M2.5x8.SLDPRT
