kaansancakdar/Stewart_Platform/memememe-master/memememe-master/Android/selfieMemememe/app/src/main/java/memememe/me/selfiememememe/MemememeActivity.java

package memememe.me.selfiememememe;

import java.io.File;
import java.io.FileOutputStream;
import java.io.IOException;
import java.io.InputStream;
import java.net.InetAddress;
import java.net.SocketException;
import java.net.UnknownHostException;
import java.util.Random;

// Android Classes
import android.app.AlarmManager;
import android.app.PendingIntent;
import android.content.Intent;
import android.support.v7.app.AppCompatActivity;
import android.content.Context;
import android.hardware.Camera;
import android.hardware.Camera.CameraInfo;
import android.os.Bundle;
import android.os.Environment;
import android.util.Log;
import android.view.WindowManager;
import android.widget.Toast;
//OpenCV
import org.opencv.android.BaseLoaderCallback;
import org.opencv.android.CameraBridgeViewBase;
import org.opencv.android.CameraBridgeViewBase.CvCameraViewFrame;
import org.opencv.android.CameraBridgeViewBase.CvCameraViewListener2;
import org.opencv.android.LoaderCallbackInterface;
import org.opencv.android.OpenCVLoader;
import org.opencv.core.Core;
import org.opencv.core.Mat;
import org.opencv.core.MatOfRect;
import org.opencv.core.Point;
import org.opencv.core.Rect;
import org.opencv.core.Scalar;
import org.opencv.core.Size;
import org.opencv.imgproc.Imgproc;
import org.opencv.imgcodecs.Imgcodecs;

//extras
import com.illposed.osc.OSCMessage;
import com.illposed.osc.OSCPortOut;
import com.tumblr.jumblr.JumblrClient;
import com.tumblr.jumblr.exceptions.JumblrException;
import com.tumblr.jumblr.types.PhotoPost;

public class MemememeActivity extends AppCompatActivity implements CvCameraViewListener2, Thread.UncaughtExceptionHandler{
    private static enum State {WAITING, SEARCHING, CHILLING, REFLECTING, FLASHING, POSTING, SCANNING,
        MAKING_REFLECT_NOISE, MAKING_PICTURE_NOISE};

    private static final boolean MEMEMEME_SELFIE = false;
    private static final String TAG = "MEMEMEME::SELFIE";
    private static final String SELFIE_FILE_NAME = "memememeselfie";
    private static final String[] TEXTS = {"me", "meme", "mememe", "memememe", "#selfie"};
    private static final Scalar FACE_RECT_COLOR = new Scalar(0, 255, 0, 255);
    private static final Scalar SCREEN_COLOR_FLASH = new Scalar(160, 160, 160, 255);
    private static final Scalar SCREEN_COLOR_BLACK = new Scalar(0, 0, 0, 255);
    private static final String OSC_OUT_ADDRESS = "10.10.0.1";
    private static final int OSC_OUT_PORT = 8888;

    private static final int TIMEOUT_SEARCHING = 15000;
    private static final int TIMEOUT_SCANNING = 10000;
    private static final int TIMEOUT_REFLECTING = 10000;
    private static final int TIMEOUT_MAKING_NOISE = 2000;
    private static final int TIMEOUT_FLASHING = 4000;
    private static final int DELAY_FLASHING = 1000;
    private static final int TIMEOUT_WAITING = 5000;
    private static final int TIMEOUT_CHILLING = 60000;
    private static final int TIMEOUT_CHILLING_SCANNING = 20000;
    private static final int PERIOD_POSTING = 90000;
    private static final int PERIOD_HEARTBEAT = 1000;
    private static final int NUMBER_OF_LOOKS_WHILE_CHILLING = (MEMEMEME_SELFIE)?3:0;
    private static final int TIME_BEFORE_RESTART_APP = 180000;

    private static final String TUMBLR_BLOG_ADDRESS = (MEMEMEME_SELFIE)?"memememeselfie.tumblr.com":"memememe2memememe.tumblr.com";

    private Mat mRgba;
    private Mat mGray;
    private Mat mTempRgba;
    private Mat mTempT;
    private MatOfRect detectedRects;
    private Rect[] detectedArray;

    private int mAbsoluteDetectSize = 0;

    private DetectionBasedTracker mNativeDetector;
    private CameraBridgeViewBase mOpenCvCameraView;
    private OSCPortOut mOscOut;

    private State mCurrentState, mLastState;
    private long mLastStateChangeMillis;
    private long mLastHeartbeatSendMillis;
    private long mLastSuccessfulTumblrPostMillis;
    private long mCurrentWaitingPeriodMillis;
    private Point mCurrentFlashPosition;
    private int mCurrentNumberOfLooksWhileChilling;
    private Random mRandomGenerator;
    private int mImageCounter;

    private JumblrClient mTumblrClient;

    private NoiseReader mNoiseReader = null;
    private NoiseWriter mNoiseWriter = null;
    private Thread noiseReaderThread = null;
    private Thread noiseWriterThread = null;

    private BaseLoaderCallback  mLoaderCallback = new BaseLoaderCallback(this) {
        @Override
        public void onManagerConnected(int status) {
            if(status == LoaderCallbackInterface.SUCCESS){
                Log.i(TAG, "OpenCV loaded successfully");

                // Load native library after(!) OpenCV initialization
                System.loadLibrary("detection_based_tracker");

                try {
                    // load cascade file from application resources

                    InputStream is = getResources().openRawResource(R.raw.haarcascade_nexus);
                    File cascadeDir = getDir("cascade", Context.MODE_PRIVATE);
                    File mCascadeFile = new File(cascadeDir, "haarcascade_nexus.xml");

                    //InputStream is = getResources().openRawResource(R.raw.haarcascade_nexus);
                    //File cascadeDir = getDir("cascade", Context.MODE_PRIVATE);
                    //mCascadeFile = new File(cascadeDir, "cascade.xml");
                    FileOutputStream os = new FileOutputStream(mCascadeFile);

                    byte[] buffer = new byte[4096];
                    int bytesRead;
                    while ((bytesRead = is.read(buffer)) != -1) {
                        os.write(buffer, 0, bytesRead);
                    }
                    is.close();
                    os.close();

                    mNativeDetector = new DetectionBasedTracker(mCascadeFile.getAbsolutePath(), 0);
                    mNativeDetector.start();
                    cascadeDir.delete();
                }
                catch (IOException e) {
                    e.printStackTrace();
                    Log.e(TAG, "Failed to load cascade. Exception thrown: " + e);
                }

                mOpenCvCameraView.enableView();
            }
            else{
                super.onManagerConnected(status);
            }
        }
    };

    /** Called when the activity is first created. */
    @Override
    public void onCreate(Bundle savedInstanceState) {
        Log.i(TAG, "called onCreate");
        super.onCreate(savedInstanceState);

        //start thread for UncaughtException
        Thread.setDefaultUncaughtExceptionHandler(this);
        if (getIntent().getBooleanExtra("crash", false)) {
            Toast.makeText(this, "App restarted after crash", Toast.LENGTH_SHORT).show();
        }

        getWindow().addFlags(WindowManager.LayoutParams.FLAG_KEEP_SCREEN_ON);
        setContentView(R.layout.memememe_selfie_surface_view);


        mOpenCvCameraView = (CameraBridgeViewBase) findViewById(R.id.fd_activity_surface_view);
        mOpenCvCameraView.setCvCameraViewListener(this);

        // find front-facing camera
        for(int i=0; i<Camera.getNumberOfCameras(); i++){
            CameraInfo mInfo = new CameraInfo();
            Camera.getCameraInfo(i, mInfo);
            if(mInfo.facing == CameraInfo.CAMERA_FACING_FRONT){
                mOpenCvCameraView.setCameraIndex(i);
            }
        }
        mRandomGenerator = new Random();
        mImageCounter = 0;
        mTumblrClient = new JumblrClient(
                getString(R.string.consumer_key),
                getString(R.string.consumer_secret),
                getString(R.string.oauth_token),
                getString(R.string.oauth_token_secret));

        mNoiseReader = new NoiseReader();
        mNoiseWriter = new NoiseWriter();
        noiseReaderThread = new Thread(mNoiseReader);
        noiseWriterThread = new Thread(mNoiseWriter);
    }

    @Override
    public void onPause(){
        super.onPause();
        sendCommandToPlatform("stop").start();
        Log.d(TAG, "Pausing...: Send stop");

        if (mOpenCvCameraView != null) mOpenCvCameraView.disableView();
        if(mNativeDetector != null) mNativeDetector.release();
        if(mOscOut != null) mOscOut.close();

        try{
            noiseReaderThread.interrupt();
            noiseWriterThread.interrupt();
            noiseReaderThread.join(500);
            noiseWriterThread.join(500);
        }
        catch(InterruptedException e){
            noiseReaderThread.currentThread().interrupt(); // propagating interrupt
            noiseWriterThread.currentThread().interrupt();
            Log.e(TAG, "Interrupted Exception!!: while re-joining threads onPause.");
        }
    }

    @Override
    public void onResume(){
        super.onResume();
        if (!OpenCVLoader.initDebug()) {
            Log.d(TAG, "Internal OpenCV library not found. Using OpenCV Manager for initialization");
            OpenCVLoader.initAsync(OpenCVLoader.OPENCV_VERSION_3_0_0, this, mLoaderCallback);
        } else {
            Log.d(TAG, "OpenCV library found inside package. Using it!");
            mLoaderCallback.onManagerConnected(LoaderCallbackInterface.SUCCESS);
        }

        // initialize OSC
        try{
            mOscOut = new OSCPortOut(InetAddress.getByName(OSC_OUT_ADDRESS), OSC_OUT_PORT);
        }
        catch(UnknownHostException e){
            Log.e(TAG, "Unknown Host Exception!!: while starting OscOut with (address, port): "+OSC_OUT_ADDRESS+", "+OSC_OUT_PORT);
        }
        catch(SocketException e){
            Log.e(TAG, "Socket Exception!!: while starting OscOut with (address, port): "+OSC_OUT_ADDRESS+", "+OSC_OUT_PORT);
        }

        // start sound threads if not running mememe#selfie mode
        // (no noise is made or heard if thread not running)
        if(!MEMEMEME_SELFIE){
            noiseReaderThread.start();
            noiseWriterThread.start();
        }

        // initialize state machine
        mLastState = State.SEARCHING;
        mCurrentState = State.SEARCHING;
        Log.d(TAG, "state := SEARCHING");
        // send first message to motors
        mLastHeartbeatSendMillis = System.currentTimeMillis();
        sendCommandToPlatform("reset").start();

        mLastStateChangeMillis = System.currentTimeMillis();
        mLastSuccessfulTumblrPostMillis = System.currentTimeMillis();
        mCurrentWaitingPeriodMillis = TIMEOUT_WAITING;
        mCurrentNumberOfLooksWhileChilling = 0;
    }

    public void onDestroy() {
        super.onDestroy();
        if (mOpenCvCameraView != null) mOpenCvCameraView.disableView();
        if(mNativeDetector != null) mNativeDetector.release();
        if(mOscOut != null) mOscOut.close();
    }

    // For the uncaught excpetion, try to restart the application after few minutes
    @Override
    public void uncaughtException(Thread thread, Throwable ex) {
        Log.d(TAG, "state := DETECTING CRASH - RESTATING ");
        Intent intent = new Intent(this, MemememeActivity.class);
        intent.putExtra("crash", true);
        intent.addFlags(Intent.FLAG_ACTIVITY_CLEAR_TOP
                | Intent.FLAG_ACTIVITY_CLEAR_TASK
                | Intent.FLAG_ACTIVITY_NEW_TASK);

        PendingIntent pendingIntent = PendingIntent.getActivity(MemememeApp.getInstance().getBaseContext(), 0, intent, PendingIntent.FLAG_ONE_SHOT);

        AlarmManager mgr = (AlarmManager) MemememeApp.getInstance().getBaseContext().getSystemService(Context.ALARM_SERVICE);
        mgr.set(AlarmManager.RTC, System.currentTimeMillis() + TIME_BEFORE_RESTART_APP, pendingIntent);

        //send OSC to stop platform
        sendCommandToPlatform("stop").start();

        this.finish();
        System.exit(2);
    }


    public void onCameraViewStarted(int width, int height) {
        mRgba = new Mat();
        mGray = new Mat();
        mTempRgba = new Mat();
        mTempT = new Mat();
        detectedRects = new MatOfRect();
        detectedArray = detectedRects.toArray();
    }

    public void onCameraViewStopped() {
        mNativeDetector.stop();
        mAbsoluteDetectSize = 0;
        mRgba.release();
        mGray.release();
        mTempRgba.release();
        mTempT.release();
        detectedRects.release();
    }

    private Thread sendCommandToPlatform(String cmd){
        final String theCommand = "/memememe/"+cmd;
        Thread thread = new Thread(new Runnable(){
            @Override
            public void run() {
                try{
                    mOscOut.send(new OSCMessage(theCommand));
                }
                catch(IOException e){
                    Log.e(TAG, "IO Exception!!: while sending search osc message.");
                }
                catch(NullPointerException e){
                    Log.e(TAG, "Null Pointer Exception!!: while sending search osc message.");
                }
            }
        });
        return thread;
    }

    private void detectObjects() {

        // use opencv JNI call to detect phones
        if (mNativeDetector != null) {
            mNativeDetector.detect(mGray, detectedRects);
        } else {
            Log.e(TAG, "Native Detection method is NULL");
        }
        detectedArray = detectedRects.toArray();
        detectedRects.release();

    }
    public Mat onCameraFrame(CvCameraViewFrame inputFrame) {
        mTempRgba = inputFrame.rgba();
        mTempT = inputFrame.gray().t();
        Core.flip(mTempT, mGray, 0);
        mTempT.release();

        // save images for video...
        /*
        mTempT = mTempRgba.t();
        Core.flip(mTempT, mRgba, 0);
        mTempT.release();
        String dateFilename = SELFIE_FILE_NAME+String.format("%04d", mImageCounter++)+".jpg";
        final File movFile = new File(Environment.getExternalStoragePublicDirectory(Environment.DIRECTORY_PICTURES), dateFilename);
        Highgui.imwrite(movFile.toString(), mRgba);
        */

        // only need to do this once
        if (mAbsoluteDetectSize == 0) {
            int height = mGray.cols();
            float mRelativeDetectSize = 0.15f;
            if (Math.round(height*mRelativeDetectSize) > 0) {
                mAbsoluteDetectSize = Math.round(height*mRelativeDetectSize);
            }
            mNativeDetector.setMinFaceSize(mAbsoluteDetectSize);
        }



        // states
        if(mCurrentState == State.SEARCHING){
            mTempRgba.setTo(SCREEN_COLOR_BLACK);

            //detect Objects e fill detectedArray
            detectObjects();

            // send search to motors
            if(System.currentTimeMillis()-mLastHeartbeatSendMillis > PERIOD_HEARTBEAT){
                mLastHeartbeatSendMillis = System.currentTimeMillis();
                sendCommandToPlatform("search").start();
            }

            // keep from finding too often
            if((mCurrentNumberOfLooksWhileChilling > NUMBER_OF_LOOKS_WHILE_CHILLING) &&
                    (System.currentTimeMillis()-mLastStateChangeMillis > 5000) &&
                    (detectedArray.length > 0)) {
                Log.d(TAG, "found something while SEARCHING");
                /////////////////

                Imgproc.rectangle(mTempRgba,
                        new Point(mTempRgba.width()-detectedArray[0].tl().y, detectedArray[0].br().x),
                        new Point(mTempRgba.width()-detectedArray[0].br().y, detectedArray[0].tl().x),
                        FACE_RECT_COLOR,3);

                Point imgCenter = new Point(mGray.width()/2, mGray.height()/2);
                final Point lookAt = new Point(
                        ((detectedArray[0].tl().x>imgCenter.x)?1:(detectedArray[0].br().x<imgCenter.x)?-1:0),
                        ((detectedArray[0].br().y>imgCenter.y)?-1:(detectedArray[0].tl().y<imgCenter.y)?1:0));

                if(lookAt.x < 0)
                    Log.d(TAG, "need to look to my LEFT");
                if(lookAt.x > 0)
                    Log.d(TAG, "need to look to my RIGHT");
                if(lookAt.y < 0)
                    Log.d(TAG, "need to look to my DOWN");
                if(lookAt.y > 0)
                    Log.d(TAG, "need to look to my UP");

                Thread thread = new Thread(new Runnable(){
                    @Override
                    public void run() {
                        try{
                            mOscOut.send(new OSCMessage("/memememe/stop"));
                            // like a double take
                            Point doubleTake = new Point(
                                    ((mRandomGenerator.nextFloat()>0.5)?1:-1),
                                    ((mRandomGenerator.nextFloat()>0.5)?1:-1));
                            OSCMessage lookMessage = new OSCMessage("/memememe/look");
                            lookMessage.addArgument((int)doubleTake.x);
                            lookMessage.addArgument((int)doubleTake.y);
                            mOscOut.send(lookMessage);
                            lookMessage = new OSCMessage("/memememe/look");
                            lookMessage.addArgument((int)(-doubleTake.x));
                            lookMessage.addArgument((int)(-doubleTake.y));
                            mOscOut.send(lookMessage);
                            // the lookAt values
                            lookMessage = new OSCMessage("/memememe/look");
                            lookMessage.addArgument((int)lookAt.x);
                            lookMessage.addArgument((int)lookAt.y);
                            mOscOut.send(lookMessage);
                        }
                        catch(IOException e){
                            Log.e(TAG, "IO Exception!!: while sending look osc message.");
                        }
                        catch(NullPointerException e){
                            Log.e(TAG, "Null Pointer Exception!!: while sending look osc message.");
                        }
                        mLastStateChangeMillis = System.currentTimeMillis();
                        mNoiseWriter.makeReflectNoise();
                        mLastState = State.WAITING;
                        if(MEMEMEME_SELFIE){
                            sendCommandToPlatform("scan").start();
                            mCurrentState = State.SCANNING;
                            Log.d(TAG, "state := SCANNING");
                        }
                        else{
                            mCurrentState = State.MAKING_REFLECT_NOISE;
                            Log.d(TAG, "state := MAKING_REFLECT_NOISE");
                        }
                    }
                });
                mLastStateChangeMillis = System.currentTimeMillis();
                mLastState = State.SEARCHING;
                mCurrentWaitingPeriodMillis = TIMEOUT_WAITING;
                mCurrentState = State.WAITING;
                mCurrentNumberOfLooksWhileChilling = 0;
                Log.d(TAG, "state := WAITING");
                thread.start();
            }

            // no phone detected, check for noises
            else if(mNoiseReader.isHearingReflect()){
                mLastStateChangeMillis = System.currentTimeMillis();
                mLastState = State.SEARCHING;
                mCurrentState = State.REFLECTING;
                Log.d(TAG, "state := REFLECTING");
                sendCommandToPlatform("scan").start();
            }

            else if(System.currentTimeMillis()-mLastStateChangeMillis > TIMEOUT_SEARCHING) {
                mLastStateChangeMillis = System.currentTimeMillis();
                mLastState = State.SEARCHING;
                mCurrentState = State.CHILLING;
                mCurrentNumberOfLooksWhileChilling += 1;
                Log.d(TAG, "state := CHILLING");
                sendCommandToPlatform("scan").start();
            }
        }
        else if(mCurrentState == State.CHILLING){
            long timeChilling = System.currentTimeMillis()-mLastStateChangeMillis;

            if(timeChilling > TIMEOUT_CHILLING) {
                mLastStateChangeMillis = System.currentTimeMillis();
                mLastState = State.CHILLING;
                mCurrentState = State.SEARCHING;
                Log.d(TAG, "state := SEARCHING");
            }
            else if(timeChilling > TIMEOUT_CHILLING_SCANNING) {
                if (System.currentTimeMillis() - mLastHeartbeatSendMillis > PERIOD_HEARTBEAT) {
                    mLastHeartbeatSendMillis = System.currentTimeMillis();
                    sendCommandToPlatform("stop").start();
                }
            }
            else if(System.currentTimeMillis()-mLastHeartbeatSendMillis > PERIOD_HEARTBEAT){
                mLastHeartbeatSendMillis = System.currentTimeMillis();
                sendCommandToPlatform("scan").start();
            }
            //throw new NullPointerException(); //Forces CRASH
        }
        else if(mCurrentState == State.MAKING_REFLECT_NOISE){
            mTempRgba.setTo(SCREEN_COLOR_FLASH);

            if((System.currentTimeMillis()-mLastStateChangeMillis) > TIMEOUT_MAKING_NOISE){
                mNoiseWriter.stopNoise();

                // next state logic
                if(mLastState == State.SCANNING){
                    sendCommandToPlatform("stop").start();
                    mCurrentState = State.FLASHING;
                    Log.d(TAG, "state := FLASHING");
                }
                else{
                    mCurrentState = State.SCANNING;
                    Log.d(TAG, "state := SCANNING");
                    sendCommandToPlatform("scan").start();
                }
                mLastStateChangeMillis = System.currentTimeMillis();
                mLastState = State.MAKING_REFLECT_NOISE;
            }
        }
        else if(mCurrentState == State.SCANNING){
            mTempRgba.setTo(SCREEN_COLOR_BLACK);

            //detect Objects e fill detectedArray
            detectObjects();

            // send scan to motors
            if(System.currentTimeMillis()-mLastHeartbeatSendMillis > PERIOD_HEARTBEAT){
                mLastHeartbeatSendMillis = System.currentTimeMillis();
                sendCommandToPlatform("scan").start();
            }

            if((System.currentTimeMillis()-mLastStateChangeMillis > 500) && (detectedArray.length > 0)){
                Log.d(TAG, "found something while SCANNING/LOOKING");

                // get ready for FLASH state
                // in mTempRgba coordinates!!!
                mCurrentFlashPosition = new Point(
                        mTempRgba.width()-detectedArray[0].tl().y-detectedArray[0].height/2,
                        detectedArray[0].br().x-detectedArray[0].width/2);

                mLastStateChangeMillis = System.currentTimeMillis();
                mNoiseWriter.makeReflectNoise();
                mLastState = State.SCANNING;
                if(MEMEMEME_SELFIE){
                    sendCommandToPlatform("stop").start();
                    mCurrentState = State.FLASHING;
                    Log.d(TAG, "state := FLASHING");
                }
                else{
                    mCurrentState = State.MAKING_REFLECT_NOISE;
                    Log.d(TAG, "state := MAKING_REFLECT_NOISE");
                }
            }
            // if other phone reflects me
            else if(mNoiseReader.isHearingPicture()){
                mLastStateChangeMillis = System.currentTimeMillis();
                mLastState = State.SCANNING;
                mCurrentState = State.POSTING;
                Log.d(TAG, "state := POSTING");
                sendCommandToPlatform("stop").start();
            }
            // if other phone sees me
            else if((System.currentTimeMillis()-mLastStateChangeMillis > 500) && mNoiseReader.isHearingReflect()){
                mLastStateChangeMillis = System.currentTimeMillis();
                mLastState = State.SCANNING;
                mCurrentState = State.REFLECTING;
                Log.d(TAG, "state := REFLECTING");
                sendCommandToPlatform("scan").start();
            }

            // if scanning for a while, go back to searching
            if(System.currentTimeMillis()-mLastStateChangeMillis > TIMEOUT_SCANNING){
                mLastStateChangeMillis = System.currentTimeMillis();
                mLastState = State.SCANNING;
                mCurrentState = State.SEARCHING;
                Log.d(TAG, "state := SEARCHING");
                sendCommandToPlatform("search").start();
            }
        }
        else if(mCurrentState == State.REFLECTING){
            // do nothing to image

            //detect Objects e fill detectedArray
            detectObjects();

            // send scan to motors
            if(System.currentTimeMillis()-mLastHeartbeatSendMillis > PERIOD_HEARTBEAT){
                mLastHeartbeatSendMillis = System.currentTimeMillis();
                sendCommandToPlatform("scan").start();
            }

            // if detect other phone, stop
            if(detectedArray.length > 0){
                Log.d(TAG, "found something while REFLECTING");
                mLastStateChangeMillis = System.currentTimeMillis();
                mNoiseWriter.makePictureNoise();
                mLastState = State.REFLECTING;
                mCurrentState = State.MAKING_PICTURE_NOISE;
                Log.d(TAG, "state := MAKING_PICTURE_NOISE");
                sendCommandToPlatform("stop").start();
            }
            // if other phone sees me
            else if(mNoiseReader.isHearingReflect()){
                mLastStateChangeMillis = System.currentTimeMillis();
                mLastState = State.REFLECTING;
                mCurrentState = State.REFLECTING;
                Log.d(TAG, "state := REFLECTING");
                sendCommandToPlatform("scan").start();
            }

            // if reflecting for a while, go back to searching
            if(System.currentTimeMillis()-mLastStateChangeMillis > TIMEOUT_REFLECTING){
                mLastStateChangeMillis = System.currentTimeMillis();
                mLastState = State.REFLECTING;
                mCurrentState = State.SEARCHING;
                Log.d(TAG, "state := SEARCHING");
                sendCommandToPlatform("search").start();
            }
        }
        else if(mCurrentState == State.MAKING_PICTURE_NOISE){
            // do nothing to image

            // if making noise for a while, move on
            if(System.currentTimeMillis()-mLastStateChangeMillis > TIMEOUT_MAKING_NOISE){
                mNoiseWriter.stopNoise();
                mLastStateChangeMillis = System.currentTimeMillis();
                mLastState = State.MAKING_PICTURE_NOISE;
                mCurrentState = State.SEARCHING;
                Log.d(TAG, "state := SEARCHING");
                sendCommandToPlatform("search").start();
            }
        }
        else if(mCurrentState == State.FLASHING){
            byte detectedColor[] = new byte[4];
            mTempRgba.get((int)mCurrentFlashPosition.y,(int)mCurrentFlashPosition.x,detectedColor);
            mTempRgba.setTo(SCREEN_COLOR_FLASH);

            // checking these 2 values seem to be enough
            if((System.currentTimeMillis()-mLastStateChangeMillis > DELAY_FLASHING) &&
                    ((detectedColor[1]&0xff)>200 && (detectedColor[2]&0xff)>200)){
                mLastStateChangeMillis = System.currentTimeMillis();
                mLastState = State.FLASHING;
                mCurrentState = State.POSTING;
                Log.d(TAG, "state := POSTING");
            }

            // if flashing for a while, go back to searching
            if(System.currentTimeMillis()-mLastStateChangeMillis > TIMEOUT_FLASHING){
                mLastStateChangeMillis = System.currentTimeMillis();
                mLastState = State.FLASHING;
                mCurrentState = State.SEARCHING;
                Log.d(TAG, "state := SEARCHING");
                sendCommandToPlatform("search").start();
            }
            mTempT = mTempRgba.t();
            Core.flip(mTempT, mRgba, 1);
            mTempT.release();

            for(int i=0; i<mRandomGenerator.nextInt(5)+2; i++){
                String mCurrentFlashText = TEXTS[mRandomGenerator.nextInt(TEXTS.length)];
                Size mTextSize = Imgproc.getTextSize(mCurrentFlashText, Core.FONT_HERSHEY_PLAIN, 1, 16, null);
                float mWidthScale = (float)(mRgba.width()/mTextSize.width);
                mTextSize = Imgproc.getTextSize(mCurrentFlashText, Core.FONT_HERSHEY_PLAIN, mWidthScale, 16, null);
                Point mTextOrigin = new Point(
                        mRandomGenerator.nextInt((int)(mRgba.width() - mTextSize.width)),
                        mRandomGenerator.nextInt((int)(mRgba.height() - mTextSize.height)));
                Imgproc.putText(mRgba, mCurrentFlashText, mTextOrigin, Core.FONT_HERSHEY_PLAIN, mWidthScale, SCREEN_COLOR_BLACK, 16);
            }
            mTempT = mRgba.t();
            Core.flip(mTempT, mTempRgba, 1);
            mTempT.release();

        }
        else if(mCurrentState == State.WAITING){
            mTempRgba.setTo(SCREEN_COLOR_BLACK);
            // if waiting for a while, go back to searching
            if(System.currentTimeMillis()-mLastStateChangeMillis > mCurrentWaitingPeriodMillis){
                mLastStateChangeMillis = System.currentTimeMillis();
                mLastState = State.WAITING;
                mCurrentState = State.SEARCHING;
                Log.d(TAG, "state := SEARCHING");
                sendCommandToPlatform("search").start();
            }
        }
        else if(mCurrentState == State.POSTING){
            if(System.currentTimeMillis()-mLastSuccessfulTumblrPostMillis > PERIOD_POSTING){
                mTempT = mTempRgba.t();
                Core.flip(mTempT, mRgba, 0);
                mTempT.release();

                Imgproc.cvtColor(mRgba, mRgba, Imgproc.COLOR_BGR2RGB);

                String selfieFilename = SELFIE_FILE_NAME+(System.currentTimeMillis()/1000)+".jpg";
                final File file = new File(Environment.getExternalStoragePublicDirectory(Environment.DIRECTORY_PICTURES), selfieFilename);
                Imgcodecs.imwrite(file.toString(), mRgba);

                Thread tumblrThread = new Thread(new Runnable(){
                    @Override
                    public void run() {
                        boolean success = true;
                        try{
                            PhotoPost mPP = mTumblrClient.newPost(TUMBLR_BLOG_ADDRESS, PhotoPost.class);
                            mPP.setData(file);
                            mPP.save();
                        }
                        catch(IOException e){
                            success = false;
                            Log.e(TAG, "IO Exception!!: while sending picture to tumblr.");
                        }
                        catch(JumblrException e){
                            success = false;
                            Log.e(TAG, "Jumblr Exception!!: while sending picture to tumblr.");
                            Log.e(TAG, "Response Code: "+e.getResponseCode());
                            Log.e(TAG, e.toString());
                        }
                        catch(Exception e){
                            success = false;
                            Log.e(TAG, "some Exception!!: while sending picture to tumblr.");
                            Log.e(TAG, e.toString());
                        }

                        if(success){
                            file.delete();
                            mLastSuccessfulTumblrPostMillis = System.currentTimeMillis();
                        }
                    }
                });
                tumblrThread.start();
            }

            mLastStateChangeMillis = System.currentTimeMillis();
            mLastState = State.POSTING;
            mCurrentState = State.SEARCHING;
            Log.d(TAG, "state := SEARCHING");
            sendCommandToPlatform("search").start();
            mTempRgba.setTo(SCREEN_COLOR_BLACK);
        }

        Core.flip(mTempRgba, mRgba, 1);
        return mRgba;
    }
}
